NateDogg247/EEE3094S---Lab-2-PTRJUN003-/data/reference_images/README.md

# Original pre-lab reference

The supplied handwritten model/force-diagram photograph is preserved unchanged as original source material. The report uses typeset equations and clean vector diagrams; this photograph is not a report figure.
