NateDogg247/EEE3094S---Lab-2-PTRJUN003-/data/rubric/README.md

# Supplied marking rubric

Original rubric images supplied for this report revision. These are marking instructions, not experimental measurements. Identification/check and step-circuit evidence are in `../session1/evidence`; the original model, scope and controller test are in `../session2`.
