NateDogg247/EEE3094S---Lab-2-PTRJUN003-/report/sections/appendices.tex

\section{Parameter Check and Final Board}\label{app:evidence}\label{app:photos}
\Fref{fig:paramcheck} records the submitted parameters and the laboratory check results. The displayed scores support the identification values used in \Sref{sec:id}; they are not uncertainty intervals.
\begin{figure}[H]\raggedright
\begin{minipage}[t]{.39\linewidth}\vspace{0pt}
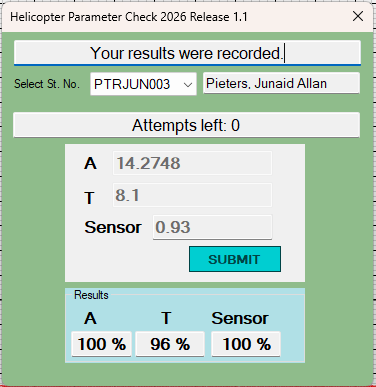
[picture p1: data/session1/evidence/parameter_check.png]
\href{\RepoRoot/tree/\RepoBranch/data/session1/evidence}{}
\end{minipage}\hfill
\begin{minipage}[t]{.57\linewidth}\vspace{0pt}
\small
\begin{tabular}{lll}\toprule\thead
Parameter & Submitted & Score\\\midrule
$A$ & 14.2748 & 100\%\\
$\tau$ & 8.1 s & 96\%\\
$k_s$ & 0.93 V/m & 100\%\\\bottomrule
\end{tabular}
\par\vspace{8pt}The check reports ``Your results were recorded'' for PTRJUN003. The numerical values agree with the model in the original Simulink diagram. The source image and identification circuit reference are retained in the \RepoLink{data/session1/evidence}{evidence folder}.
\end{minipage}
\caption{Original Helicopter Parameter Check result for the adopted model.}\label{fig:paramcheck}
\end{figure}
\Fref{fig:board} documents the final Veroboard controller described in \Sref{sec:hardware}. The three op-amp packages and adjustable bias trimmer are visible. The schematic records the intended connections; a top-side photograph alone does not establish underside continuity.
\repfig{hardware}{../../hardware/veroboard.jpeg}{.70}{Final physical controller on Veroboard. The enlarged circuit is \Fref{fig:circuit}; the editable design is in the \RepoLink{hardware/kicad}{KiCad folder}.}{fig:board}
\page

\section{Demo Record and Original Simulink Scope}\label{app:demo}\label{app:simulink}
The controller demonstration received full marks (20/20). \Fref{fig:demo} retains the required screenshot of tracking the setpoint. At 86.10 s it displays reference 5.033 m, height 4.897 m, command 2.498 V and sensor 4.553 V. The displayed error is 0.137 m; subtraction of rounded heights gives 0.136 m.
\repfig{data/session2}{../../data/session2/hardware_step_test.jpeg}{.80}{Original controller tracking screenshot required by the lab brief. The numerical response is replotted in \Fref{fig:hardware}.}{fig:demo}
\Fref{fig:originalscope} is the original supplied Simulink plot, preserved for comparison with the original model in \Fref{fig:originalmodel}. 
\repfig{data/session2}{../../data/session2/simulink_scope.png}{.80}{Original Simulink scope: reference (yellow), command (blue) and altitude (orange). The matched-reference comparison is \Fref{fig:simcomparison}.}{fig:originalscope}
Digitised values are approximate: Simulink altitude resolution is 0.0124 m/pixel, while the demo plot resolution is 0.0417 m/pixel. Source images, processed CSVs and \RepoLink{matlab/simulink}{Simulink reproduction scripts} remain accessible through the linked repository folders.
\page

\section{Supporting Calculations}\label{app:calculations}
\label{app:circuit}\label{app:loading}\label{app:adjustment}
The following enlarged KiCad view shows the bias source feeding U3. $R_{11}$ connects to ground; $R_{13}$ connects to $-15$ V. The pot wiper is loaded through $R_9$, so its unloaded voltage alone does not determine hover output.
\begin{figure}[H]\raggedright
\begin{minipage}[t]{.32\linewidth}\vspace{0pt}
\href{\RepoRoot/tree/\RepoBranch/hardware/kicad}{}
\end{minipage}\hfill
\begin{minipage}[t]{.64\linewidth}\vspace{0pt}\small
\textbf{DAQ connections:} DAC-1 reference, DAC-0 sensor, ADC-1 controller output, ADC-2 sensor monitor. All grounds are common. Op-amp pin 7 is $+15$ V and pin 4 is $-15$ V.
\par\vspace{6pt}U1: $a_f=R_4/R_3$, $a_r=(1+a_f)R_2/(R_1+R_2)$; nominally both are 0.01. U2: $g_2=1+R_5/R_6=1.47$. U3: $g_3=(1+R_{10}/(R_9+R_{\mathrm{th}}))R_8/(R_7+R_8)$.
\end{minipage}
\caption{Bias network and DAQ mapping supporting the enlarged signal stages in \Fref{fig:circuit}.}\label{fig:biasnetwork}
\end{figure}
For the unloaded network, $R_P=10\parallel1.2=1.071429$ k$\Omega$ and $I=-15/(3.9+R_P+22)=-0.556143$ mA. Thus $V_A=-2.168962$ V, $V_B=-2.764831$ V and $V_{\rm th}=V_A+W(V_B-V_A)$. Solving the loaded hover condition gives $W=0.783081$, $R_{\rm th}=5.423001$ k$\Omega$ and $V_{\rm th}=-2.635575$ V:
\begin{align}
u_0&=-\frac{100}{100+5.423001}(-2.635575)=2.500000\unit{V},\\
g_3&=\frac{1+100/(100+5.423001)}2=0.974280,\\
K_p&=0.01(1.47)(0.974280)=0.014321913.
\end{align}
The reported 2.565 V potentiometer adjustment is an observation at an unlogged node/time. A permanent zero-error bias of 2.565 V instead of 2.5 V would predict $\delta y=0.065/(0.01432\times0.93)=4.88076$ m, so it is not silently substituted for theoretical hover. The isolated 5 m step initially commands 2.566588 V; the matched Simulink sequence reaches 2.564405 V.

Independent resistor errors change $K_f=a_fg_2g_3$ and $y_\infty/x_\infty=a_r/a_f$. The 2,048 resistor/drag corners give 48.79\% maximum error and 38.95\% overshoot. For example, $a_f=0.9/110$ and $a_r=(1+a_f)1.1/(90+1.1)$ give $a_r/a_f=1.487864$. Matched ratios and two 680 $\Omega$ U1 resistors give $K_p=0.00973890$ and 23.44\% worst scalar overshoot; physical retesting is required.
At the selected root $s_d=-0.0617284+j0.1402123$, pole angles are $113.7615^\circ$ and $66.2385^\circ$ (sum $180^\circ$). The magnitude condition gives
\begin{equation}
K_p=\frac{|s_d||s_d+0.1234568|}{1.6389585}=\frac{(0.1531988)^2}{1.6389585}=0.01432.
\end{equation}
\RepoLink{calculations}{Extended calculations}, \RepoLink{analysis/modules}{Python code}, \RepoLink{matlab/design}{MATLAB root locus}, \RepoLink{matlab/simulink}{Simulink tests} and \RepoFile{CODE_GUIDE.md}{reproduction instructions} are supplied outside the report.
