NateDogg247/EEE3094S---Lab-2-PTRJUN003-/calculations/PTRJUN003_Lab2_Calculations.pdf

# Worked Calculations

### EEE3094S Lab 2 – PTRJUN003

Junaid Allan Pieters

## 1 Model, Inputs and Definitions

The original CSV and screenshot are retained in the data folder. (https://github.com/NateDogg247/EEE3094S---Lab-2-PTRJUN003-/tree/main/data) The Python modules (https://github.com/NateDogg247/EEE3094S---Lab-2-PTRJUN003-/tree/main/analysis/modules) calculate the values below; MATLAB design code (https://github.com/NateDogg247/EEE3094S---Lab-2-PTRJUN003-/tree/main/matlab/design) provides the root-locus method. This supplement contains worked substitutions rather than additional experiments.

∆u = 5.0 − 2.5 = 2.5 V, | uh = 2.5 V, | (1.1)
Gy(s) = | 14.2748
s(8.1s + 1), | ks = 0.93 V/m, | (1.2)

b =

1
8.1

= 0.123456790 s⁻¹
, | kT =
| 14.2748
| 8.1
| = 1.762320988, | (1.3)
L(s) = KpksGy(s), | Kp = 0.01432. | (1.4)

The closed-loop reference is a position step from 0 to 5 m; the identification input is a voltage step from 2.5 to 5.0 V. They are different signals.

ks =

P
i
P
| yiyv,i

i

y

2
i
| . | (1.5)

Mp = 100e

−πζ/√
1−ζ

2
. | (1.6)

y(t) = 5
1 − e

−σt
cos ωdt +

σ
ωd

sin ωdt

. | (1.7)

δy =

δub
Kpks
| . | (1.8)

The circuit coefficients used for tolerance calculations are

af = R4/R3, | ar = (1 + af )R2/(R1 + R2), | (1.9)
g2 = 1 + R5/R6, | g3 = (1 + R10/(R9 + Rth))R8/(R7 + R8). | (1.10)

2 Detailed Calculations

## 2 Detailed Calculations

### 2.1 Model Derivation and Signal Definitions

Table 2.1: Model notation and units.

Symbol | Description | Unit
x, y, v = ˙y | Reference altitude, altitude, vertical velocity | m, m, m/s
ft
, g, da | Mass-normalised thrust, gravity, disturbance | m/s²
b, kT | Drag coefficient; local voltage-to-thrust slope | s⁻¹ ; m/(s² V)
u, uh, δu | Command, hover command, u − uh | V
A, τ | Velocity gain; velocity time constant | m/(s V); s
ks | Position-to-voltage coefficient | V/m
rv, yv, ev | Reference, sensor, error voltage | V
Kp | Proportional voltage-error gain | V/V

Start from y¨ = ft−by˙ −g+da, with ft = g+kT (u−uh). For da = 0, zero initial conditions and v = ˙y,

v˙ + bv = kT δu, | (2.1)
(s + b)V (s) = kT ∆U(s), | (2.2)
Gv(s) = kT
s + b

=

kT /b
s/b + 1

=

A
τs + 1
| , | (2.3)

Gy(s) = Gv(s)
| s = A
| s(τs + 1). | (2.4)

The identified parameters give b = 1/8.1 = 0.123456790 s⁻¹ and kT = 14.2748/8.1 = 1.762320988 m/(s² V). The hover voltage does not imply kT = g/uh.

For negative feedback, Ey = X − Y and L = KpksGy:

Ey(s)
X(s)

=

1
1 + L(s)
| = τs² + s
| τs² + s + AKpks
| . | (2.5)

For a step X = x0/s, the final-value theorem gives e∞ = lims→0 sEy(s) = 0. For a ramp X = ar/s²
,
e∞ =

ar
AKpks
, | Kv = AKpks = 0.190106076. | (2.6)

A parabolic reference has unbounded steady error. A constant acceleration disturbance d0 instead gives y∞−x∞ = d0/(kT Kpks). For an input bias, d0 = kT δub, so δy = δub/(Kpks).

### 2.2 Identification and Timing

Table 2.2 gives selected original samples and derived velocities. The finite manual step is evident in the input column. Endpoint times are listed for consistency with the CSV; each derivative physically belongs to its interval midpoint.

Table 2.2: Selected identification samples and backward-difference results.

t [s] | u [V] | yv [V] | y [m] | vi [m/s]
15.7 | 2.495 | 0.000 | 0.000 | 0.00
15.8 | 2.908 | 0.000 | 0.000 | 0.00
15.9 | 4.607 | 0.000 | 0.000 | 0.00
16.0 | 5.000 | 0.034 | 0.037 | 0.37
16.9 | 5.000 | 2.098 | 2.256 | 4.08
17.0 | 5.000 | 2.513 | 2.703 | 4.47
23.9 | 5.000 | 10.000 | 104.823 | 22.36
24.0 | 5.000 | 10.000 | 107.076 | 22.53
24.1 | 5.000 | 10.000 | 109.345 | 22.69
v(24.0) = (107.076 − 104.823)/0.1 = 22.53 m/s, | (2.7)
v(24.1) = (109.345 − 107.076)/0.1 = 22.69 m/s, | (2.8)

v¯∞ =

1
404

X

ti≥120

yi − yi−1
0.1
= 35.68747525 m/s, | (2.9)
A = (35.68747525 − 0)/2.5 = 14.27499010 m/(s V), | (2.10)
v63 = 0.632(35.68747525) = 22.55448436 m/s, | (2.11)

t63 = 24.0 + 0.1

22.55448436 − 22.53
22.69 − 22.53
= 24.01530272 s, | (2.12)
τ63 = 24.01530272 − 15.9 = 8.11530272 s. | (2.13)

The exponential fit minimises P
17≤ti≤60[vi − V∞(1 − e

−(ti−t0)/τ )]²
. Its outputs are V∞ =
35.68747059 m/s, τ = 8.10393362 s and t0 = 15.91583783 s. These two methods corrobo-rate rounding to τ = 8.1 s. They do not create two experimental trials.

The sensor least-squares fit in Equation (1.5) excludes zero and clipped pairs. The check ks(2.703) = 0.93(2.703) = 2.51379 V agrees with the recorded 2.513 V within rounding.

### 2.3 Root-Locus Geometry and Gain Bound

Step 1 – Form the loop without the variable gain. Include the sensor coefficient explicitly:
G0(s) = ksGy(s) = 14.2748(0.93) s(8.1s + 1) =

1.638958519
s(s + 0.123456790). | (2.14)
Step 2 – Locate poles and asymptotes. The two poles are p1 = 0 and p2 = −0.123456790; there are no finite zeros. The real-axis locus is between the poles. With n − m = 2,

σa =

p1 + p2
2

= −0.061728395, θℓ =

(2ℓ + 1)180◦
2

= 90◦

, 270◦
. (2.15)
Step 3 – Calculate breakaway. From 1 + KpG0(s) = 0,

Kp(s) = −

s(8.1s + 1)
14.2748(0.93), | (2.16)

dKp
ds = −

16.2s + 1
13.275564
= 0 | ⇒ | sb = −

1
16.2
= −0.061728395, | (2.17)

Kp,b =

1
4(8.1)(14.2748)(0.93) = 0.002324888. | (2.18)
Step 4 – Apply the overshoot bound. Solving 0.30 = e

−πζ/√
1−ζ

2
gives

ζmin =

− ln 0.30
p
π

2 + (ln 0.30)²

= 0.357857131. | (2.19)

The characteristic polynomial is s

2 + s/8.1 + (14.2748)(0.93)Kp/8.1. Matching coefficients gives ω

2
n = AKpks/τ and 2ζωn = 1/τ , hence

Kp <

1
4τAksζ

2
min

=

1
4(8.1)(14.2748)(0.93)(0.357857131)²

= 0.018154432. (2.20)

The adopted Kp = 0.01432 lies between breakaway and the nominal overshoot limit. The complex branches have fixed decay rate σ = 1/(2τ ) = 0.061728395 s⁻¹
; they cannot reach
σ = 4/30 = 0.133333 s⁻¹ by changing Kp alone.

### 2.4 Selected Gain and Pole Calculations

Step 5 – Check the adopted gain. This value is retained from the supplied controller design; the calculations test its performance. Substitution gives
q = AKpks = (14.2748)(0.01432)(0.93) = 0.190106076, | (2.21)
Gcl(s) = | 0.190106076
8.1s

2 + s + 0.190106076

, | (2.22)

ωn =

p
q/τ =

p
0.190106076/8.1 = 0.153198845 rad/s, | (2.23)

ζ =

1
2

√τ q

=

1
2

p
8.1(0.190106076)
= 0.402929900, | (2.24)

ωd =

p
ω²
n − σ
2 = 0.140212308 rad/s, | (2.25)

s1,2 =

−1 ±

p
1 − 4(8.1)(0.190106076)
2(8.1) | = −0.061728395 ± j0.140212308. | (2.26)
The damping predicts Mp = 100e | −π(0.402929900)/

√
1−0.402929900² = 25.080375%. The next angle and magnitude checks verify that these poles lie on the proportional root locus.

### 2.5 Root-Locus Angle and Magnitude Checks

Step 6 – Verify the pole position. The locus for variable Kp uses G0(s) = ksGy(s) = (Aks/τ )/[s(s + 1/τ )], where Aks/τ = 1.638959 s⁻²
. At the selected upper pole sd = −0.0617284 + j0.1402123,

∠sd = 113.76147◦

, | ∠(sd + 1/τ ) = 66.23853◦
| , | (2.27)
∠G0(sd) = −113.76147◦ − 66.23853◦ = −180◦
| , | (2.28)

Kp =

1
|G0(sd)|

=

|sd| |sd + 1/τ |
Aks/τ | =
| (0.153198845)²
| 1.63895852
| = 0.01432. | (2.29)

Both the negative-feedback angle criterion and magnitude criterion are satisfied. The quadratic roots independently give the same pole pair.

### 2.6 Nominal Step and Settling Calculation

Step 7 – Evaluate the time response. Substituting into Equation (1.7),

y(t) = 5 -1 − e

−0.061728395t
(cos(0.140212308t) + 0.44025 sin(0.140212308t)) . (2.30)

The first peak occurs at tp = π/ωd = 22.405969 s. Since cos π = −1 and sin π = 0,

y(tp) = 5[1 + e

−0.061728395(22.405969)] = 6.254019 m, | (2.31)

so Mp = (6.254019 − 5)/5 × 100 = 25.080375%.

Step 8 – Calculate settling. The error envelope satisfies |y − 5|/5 ≤ e

−σt/

p
| 1 − ζ
| 2 .
Solving this bound for 2% gives

Tenv = −

ln(0.02√
1 − 0.4029299²
)
0.061728395
= 64.80975 s. | (2.32)

Actual settling is found by evaluating the full response, locating the last sample for which |y − 5| > 0.1 m, and taking the next sample. A 0.005 s grid gives 54.89 s. This definition agrees with reference-based settling calculations [1].

Step 9 – Check command headroom. Command headroom follows from u = 2.5 + Kpks(5 − y): the highest command is 2.566588 V at the step, and the lowest is 2.5 − 0.01432(0.93)(1.254019) = 2.483299 V at the altitude peak. Neither reaches the 0 or 5 V limit.

### 2.7 Aerodynamic and Component Uncertainty

With fixed kT , the uncertain characteristic polynomial is s

2 + b

′
s + kT Kpks. The worst
scalar case has b

′ = 0.9b0 and K′
p = 1.1Kp,0. Applying the required damping ratio gives

Kp,0 <

(0.9b0)

2
4kT ksζ

2

min(1.1) =

0.81
1.1
(0.01815443) = 0.01336826. | (2.33)

At the supplied gain the worst-case damping is (0.9/

√
1.1)(0.4029299) = 0.34575, and Equation (1.6) gives 31.42% overshoot. This explains why passing drag-only uncertainty is insufficient for the joint case.

For independent loop-resistor tolerances, use the U1 coefficients and U2/U3 gains defined in Section 3. Assign each of R1–R10 either 0.9 or 1.1 times its nominal value, then use both drag extremes. There are 2¹⁰ × 2 = 2048 cases. The bias network is held at its nominal Thevenin resistance and zero-error output is recalibrated in each case. Table 2.3 reports this optimistic subset.

Table 2.3: Independent loop-resistor corner predictions.

Quantity | Range / worst value
Feedback gain Kf | 0.009072–0.022784
Reference/feedback ratio ar/af | 0.672104–1.487864
Absolute DC tracking error | 48.7864%
Overshoot about each case’s own final altitude | 38.9461%

For example, R1 = 0.9(100 kΩ), R2 = 1.1(1 kΩ), R3 = 1.1(100 kΩ) and R4 = 0.9(1 kΩ) give

af = 0.9/110 = 0.00818182,

ar
af

=

(1 + 0.00818182)(1.1)/(90 + 1.1) 0.00818182

= 1.487864.

(2.34)
Thus a 5 m reference tends to 7.43932 m even after hover recalibration. The type number cannot remove unequal reference and feedback scaling.

### 2.8 Practical Gain and Ratio Correction

The corner distributions in Figure 2.1 separate dynamic overshoot from DC ratio error.

20 | 30 | 40

### Overshoot (%)

0

50

100

150

### Corner count

0 | 20 | 40

### Tracking error after bias trim (%)

0

200

400

600

800

Corner count (https://github.com/NateDogg247/EEE3094S---Lab-2-PTRJUN003-/tree/main/analysis/modules)

Figure 2.1: Loop-resistor corners. Dashed limits are 30% overshoot and 8% tracking error. The histograms show corner counts, not probabilities. Code: Python; (https://github.com/NateDogg247/EEE3094S---Lab-2-PTRJUN003-/tree/main/analysis/modules) MATLAB. (https://github.com/NateDogg247/EEE3094S---Lab-2-PTRJUN003-/tree/main/matlab/plots) Data: results. (https://github.com/NateDogg247/EEE3094S---Lab-2-PTRJUN003-/tree/main/results)

Failure in this subset rejects a guarantee for all components. Bias-network and op-amp variations can add error. After matching the U1 ratios, a practical gain correction is to replace both 1 kΩ resistors with matched 680 Ω values:

Kp,new =

680
100000
(1.47)(0.97427980) = 0.009738901, | (2.35)

ζworst =

0.9b0
2

p
kT (1.1Kp,new)ks
≈ 0.4193, | (2.36)
Mp,worst ≈ 23.44%, | (2.37)
|δub|max = 0.08(5)(0.009738901)(0.93) = 3.623 mV. | (2.38)

This scalar check assumes matched reference and feedback ratios; it is not a guarantee for independent resistor corners. Lower gain increases damping but tightens the hover-bias allowance. The board must be recalibrated and retested after any change.

### 2.9 Reported Potentiometer Adjustment and Command Calculations

The complete physical three-op-amp controller was connected during the controller test. The student reported adjusting the physical potentiometer until the input was approximately 2.565 V, with the aim of tracking the setpoint with minimal overshoot. No time series or exact measurement instant accompanies that recollection. The retained terminal display independently records a 2.498 V command at 86.10 s.

For the isolated 0-to-5 m reference test, starting at zero altitude,

rv(0⁺) = ksx = 0.93(5) = 4.650 V, | | (2.39)
ev(0⁺) = rv − yv = 4.650 − 0 = 4.650 V, | (2.40)
δu(0⁺) = Kpev = 0.01432(4.650) = 0.066588 V, | (2.41)
u(0⁺) = uh + δu = 2.500000 + 0.066588 = 2.566588 V, | (2.42)
ureported − u(0⁺) = 2.565 − 2.566588 = −0.001588 V. | (2.43)

The difference in voltage magnitude is approximately 1.59 mV. This comparison does not establish that the reported observation was measured at the same instant or node as the model command.

For the supplied Simulink startup sequence, define the unit closed-loop response

h(t) = 1 − e

−σt
cos ωdt +

σ
ωd

sin ωdt

, | h(t) = 0 for t < 0. | (2.44)

Superposition gives y(t) = 2.5h(t) + 2.5h(t − 2.5) for a reference of 2.5 m initially and 5 m after 2.5 s. Consequently,

u(2.5

+) = 2.5 + 0.01432(0.93){5 − 2.5h(2.5)} = 2.564405 V. | (2.45)

This maximum differs from the reported 2.565 V by approximately 0.595 mV. The original scope’s voltage resolution is approximately 0.0124 V/pixel, so it cannot verify either millivolt difference.

The command during a reference error must be distinguished from the zero-error hover bias. If 2.565 V were instead held as a constant zero-error command, its 65 mV excess would predict

δy =

2.565 − 2.500
Kpks

=

0.065
0.01432(0.93) = 4.88076 m. | (2.46)

That is not a negligible hover-bias change. Therefore the reported adjustment is docu-mented as a practical test observation, rather than silently replacing the nominal 2.500 V hover term or the calculated controller gain. Changing the bias alone does not change the damping ratio or remove the proportional controller’s settling limitation.

### 2.10 Experimental Metrics and Uncertainty

The digitised plot uses pixel bounds x = 602 . . . 1414 for 0–120 s and py = 60 . . . 540 for 20–0 m. Therefore

t =

x − 602
1414 − 602
| (120), | h =

540 − py
540 − 60
(20), | (2.47)
∆t = 0.147783 s/pixel, | ∆h = 0.041667 m/pixel. | (2.48)

The extracted peak is 6.229167 m at 22.019704 s. With the displayed reference, terminal height and zero starting altitude,

ef = 5.033 − 4.897 = 0.136 m, | (2.49)
ηtrack = 100(1 − 0.136/5.033) = 97.297834%, | (2.50)
Mp,ref = 100(6.229167 − 5.033)/5.033 = 23.766475%, | (2.51)
δMp,ref ≈ 100(0.041667)/5.033 = 0.82787 percentage points. | (2.52)

This practical overshoot metric uses the commanded reference. If the terminal display is used as a proxy for the actual settled output, the conventional final-output-normalised overshoot is (6.229167 − 4.897)/4.897 × 100 ≈ 27.20%. Both estimates are below 30%, but the screenshot alone does not establish an exact asymptotic output. Table 2.4 compares the analytical, simulated and experimental metrics.

Table 2.4: Comparison of calculation, simulation and retained experiment.

Metric | Analytical | Simulation | Experiment
Reference | 5.000 m | 5.000 m | 5.033 m
Peak | 6.25402 m | 6.25402 m | ≈ 6.229 m
Peak time | 22.40597 s | 22.405 s | ≈ 22.020 s
Reference overshoot | 25.0804% | 25.0804% | ≈ 23.7665%
Tracking accuracy | 100% ideal | → 100% | 97.2978% displayed
2% reference settling | 64.81 s envelope | 54.89 s | Not established

For the 5.033 m reference the 8% band is 5.033(1 ± 0.08) = 4.63036–5.43564 m. The 2% band is 4.93234–5.13366 m. The terminal height lies inside the first but outside the second. The discrepancy cannot be removed by redefining the settling band around the biased terminal value while claiming reference tracking.

The command-bias calculation uses Equation (1.8): δy = 0.002/(0.01432 × 0.93) = 0.150177 m. The illustrative test in Figure 4.1 injects a positive 2 mV bias at 70 s; it is a model prediction rather than a recorded disturbance experiment.

3 Circuit Gain and Bias Loading

## 3 Circuit Gain and Bias Loading

With the wiper unloaded, RP = P1 ∥ R12 = 10 ∥ 1.2 = 1.0714286 kΩ. The end-to-end current and pot-end voltages are

I =

−15
3.9 + 1.0714286 + 22
= −0.556143 mA, | (3.1)
VA = I(3.9) = −2.168962 V, | VB = I(3.9 + 1.0714286) = −2.764831 V, | (3.2)
Vth = VA + W(VB − VA). | (3.3)

Set the supply sources to zero and inject a 1 A test current at the wiper. The node-conductance equations for A, B and the wiper are
G11 + G12 + Gt | −G12 | −Gt
−G12 | G13 + G12 + Gb | −Gb
−Gt | −Gb | Gt + Gb

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
- , | (3.4)

where Gi = 1/Ri

, Gt = 1/(W P1) and Gb = 1/[(1 − W)P1]. The test voltage V

′
w gives
Rth. Solving the hover equation

−

R10
R9 + Rth(W)
Vth(W) = 2.5 | (3.5)

gives W = 0.783080594, Rth = 5423.0014 Ω and Vth = −2.6355750 V. The loaded zero-error wiper is −2.500 V.

For U3, define r = R10/(R9 + Rth) = 0.94855960. Since the non-inverting divider gives V+ = V2/2, virtual short and KCL give

u = (1 + r)V+ − rVth =

1 + r
2
V2 − rVth, | (3.6)

g3 =

1 + 0.94855960
2
= 0.97427980, | (3.7)

Kp =

1

100 1 +
4.7

10
(0.97427980) = 0.014321913. | (3.8)

The ideal buffered result 0.0147 differs by 2.57%, while the selected model value 0.01432 differs from the loaded calculation by only 0.0134%. These are circuit-model calculations; a measured input/output slope of the final board was not supplied.

References

## 4 Defined Disturbance Prediction

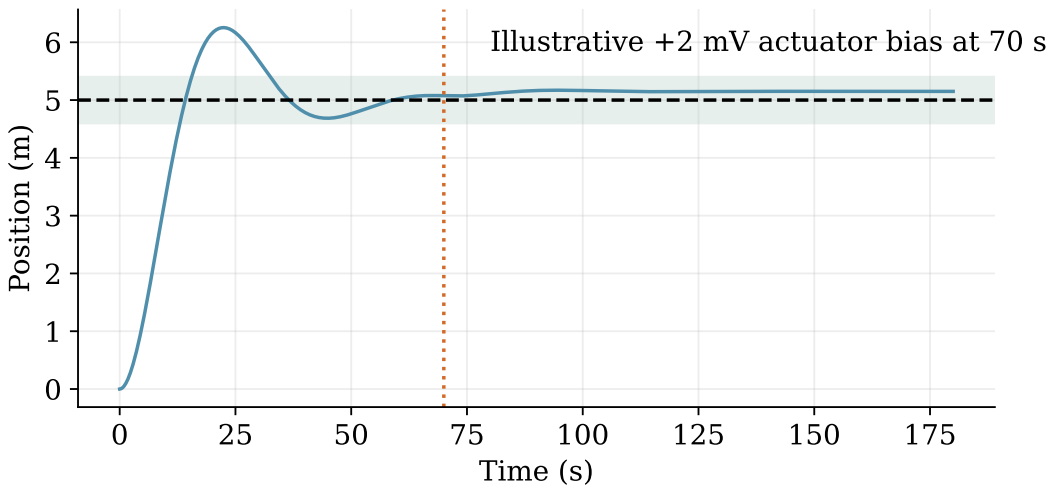
[picture p15: figure]
Time (s); Position (m)

Illustrative +2 mV actuator bias at 70 s (https://github.com/NateDogg247/EEE3094S---Lab-2-PTRJUN003-/tree/main/analysis/modules)

Figure 4.1: Prediction for a +2 mV command bias introduced at 70 s; the shaded band is the 8% reference band. Code: Python; (https://github.com/NateDogg247/EEE3094S---Lab-2-PTRJUN003-/tree/main/analysis/modules) MATLAB. (https://github.com/NateDogg247/EEE3094S---Lab-2-PTRJUN003-/tree/main/matlab/plots) Data: results. (https://github.com/NateDogg247/EEE3094S---Lab-2-PTRJUN003-/tree/main/results)

The nominal shift is 0.002/(0.01432 × 0.93) = 0.150177 m. This simulation is a prediction for a specified disturbance, not an experimentally measured rejection test.

## References

[1] MathWorks, stepinfo: official documentation. (https://www.mathworks.com/help/control/ref/dynamicsystem.stepinfo.html)
