NateDogg247/EEE3094S---Lab-2-PTRJUN003-/report/main.tex

\documentclass[12pt,a4paper,fleqn]{article}
\usepackage[utf8]{inputenc}
\usepackage[english]{babel}
\usepackage[top=1in,bottom=1in,left=1in,right=1in,headheight=15pt]{geometry}
\usepackage{microtype,amsmath,amssymb,graphicx,booktabs,array,tabularx,float}
\usepackage[table]{xcolor}
\usepackage{tikz,circuitikz,fancyhdr,enumitem,listings,caption,titlesec}
\usepackage{ragged2e}
\setlength{\mathindent}{0pt}
\usetikzlibrary{arrows.meta,positioning,calc}
\definecolor{AngelBlue}{HTML}{8FC9E6}
\definecolor{LinkBlue}{HTML}{397B9C}
\colorlet{navy}{LinkBlue}
\usepackage[unicode,colorlinks=true,linkcolor=LinkBlue,urlcolor=LinkBlue,citecolor=LinkBlue,bookmarksnumbered=true]{hyperref}
\hypersetup{pdftitle={EEE3094S Lab 2: Proportional Control},pdfauthor={Junaid Allan Pieters},pdfsubject={Kitticopter modelling, identification and proportional control}}
\providecommand{\ReportRoot}{}
\providecommand{\ProjectRoot}{../}
\graphicspath{{\ReportRoot figures/}}
% Computer Modern, margins and leading follow the supplied LaTeX template.
\linespread{1.03}
\setlength{\parskip}{5pt plus1pt minus1pt}
\setlength{\parindent}{0pt}
\setlength{\intextsep}{7pt}
\setlength{\textfloatsep}{8pt}
\setlength{\emergencystretch}{2em}
\widowpenalty=10000\clubpenalty=10000
\setlist{nosep,leftmargin=*}
\renewcommand{\arraystretch}{1.14}
\renewcommand{\tabularxcolumn}[1]{>{\RaggedRight\arraybackslash}p{#1}}
\newcolumntype{P}[1]{>{\RaggedRight\arraybackslash}p{#1}}
\captionsetup{font=small,labelfont=bf,skip=4pt,justification=raggedright,singlelinecheck=false}
\pagestyle{fancy}\fancyhf{}
\fancyhead[L]{\small\nouppercase{\leftmark}}\fancyfoot[L]{\thepage}
\renewcommand{\headrulewidth}{0pt}
% Chapter-style headings follow the supplied previous-year report.
\titleformat{\section}[hang]{\normalfont\Large\bfseries}
  {\thesection}{0.6em}{}
\titlespacing*{\section}{0pt}{0pt}{10pt}
\titlespacing*{\subsection}{0pt}{8pt}{5pt}
\numberwithin{equation}{section}
\makeatletter
\renewcommand{\@pnumwidth}{2.2em}
\renewcommand{\@tocrmarg}{3.2em}
\makeatother
\counterwithin{figure}{section}\counterwithin{table}{section}
\newcommand{\HRule}{\textcolor{AngelBlue}{\rule{\linewidth}{0.5mm}}}
\newcommand{\fig}[4]{\begin{figure}[H]\raggedright\href{\RepoRoot/tree/\RepoBranch/report/figures}{}\caption{#3}\label{#4}\end{figure}}
\newcommand{\plot}[4]{\begin{figure}[H]\raggedright\href{\RepoRoot/tree/\RepoBranch/analysis/modules}{}\caption{#3 \RepoLink{analysis/modules}{Python}, \RepoLink{matlab/plots}{MATLAB}, \RepoLink{results}{data}.}\label{#4}\end{figure}}
\newcommand{\repfig}[5]{\begin{figure}[H]\raggedright\href{\RepoRoot/tree/\RepoBranch/#1}{}\caption{#4}\label{#5}\end{figure}}
\newcommand{\page}{\clearpage}
\newcommand{\unit}[1]{\,\mathrm{#1}}
\newcommand{\Fref}[1]{\hyperref[#1]{Figure~\ref*{#1}}}
\newcommand{\Tref}[1]{\hyperref[#1]{Table~\ref*{#1}}}
\newcommand{\Aref}[1]{\hyperref[#1]{Appendix~\ref*{#1}}}
\newcommand{\Sref}[1]{\hyperref[#1]{Section~\ref*{#1}}}
\newcommand{\Eref}[1]{\hyperref[#1]{Equation~(\ref*{#1})}}
\newcommand{\thead}{\rowcolor{AngelBlue!28}}
\input{\ReportRoot repository.tex}
\begin{document}
\RaggedRight
\setlength{\abovedisplayskip}{5pt}
\setlength{\belowdisplayskip}{5pt}
\setlength{\abovedisplayshortskip}{4pt}
\setlength{\belowdisplayshortskip}{4pt}
\fancypagestyle{plain}{\fancyhf{}\fancyfoot[L]{\thepage}\renewcommand{\headrulewidth}{0pt}}
\hypersetup{pageanchor=false}
\begin{titlepage}\thispagestyle{empty}\begin{flushleft}
{\LARGE Lab 2 Report}\\[0.3cm]
{\large Proportional Control}\\[0.6cm]
\textcolor{AngelBlue}{\rule{0.60\linewidth}{0.5pt}}\\[1.0cm]
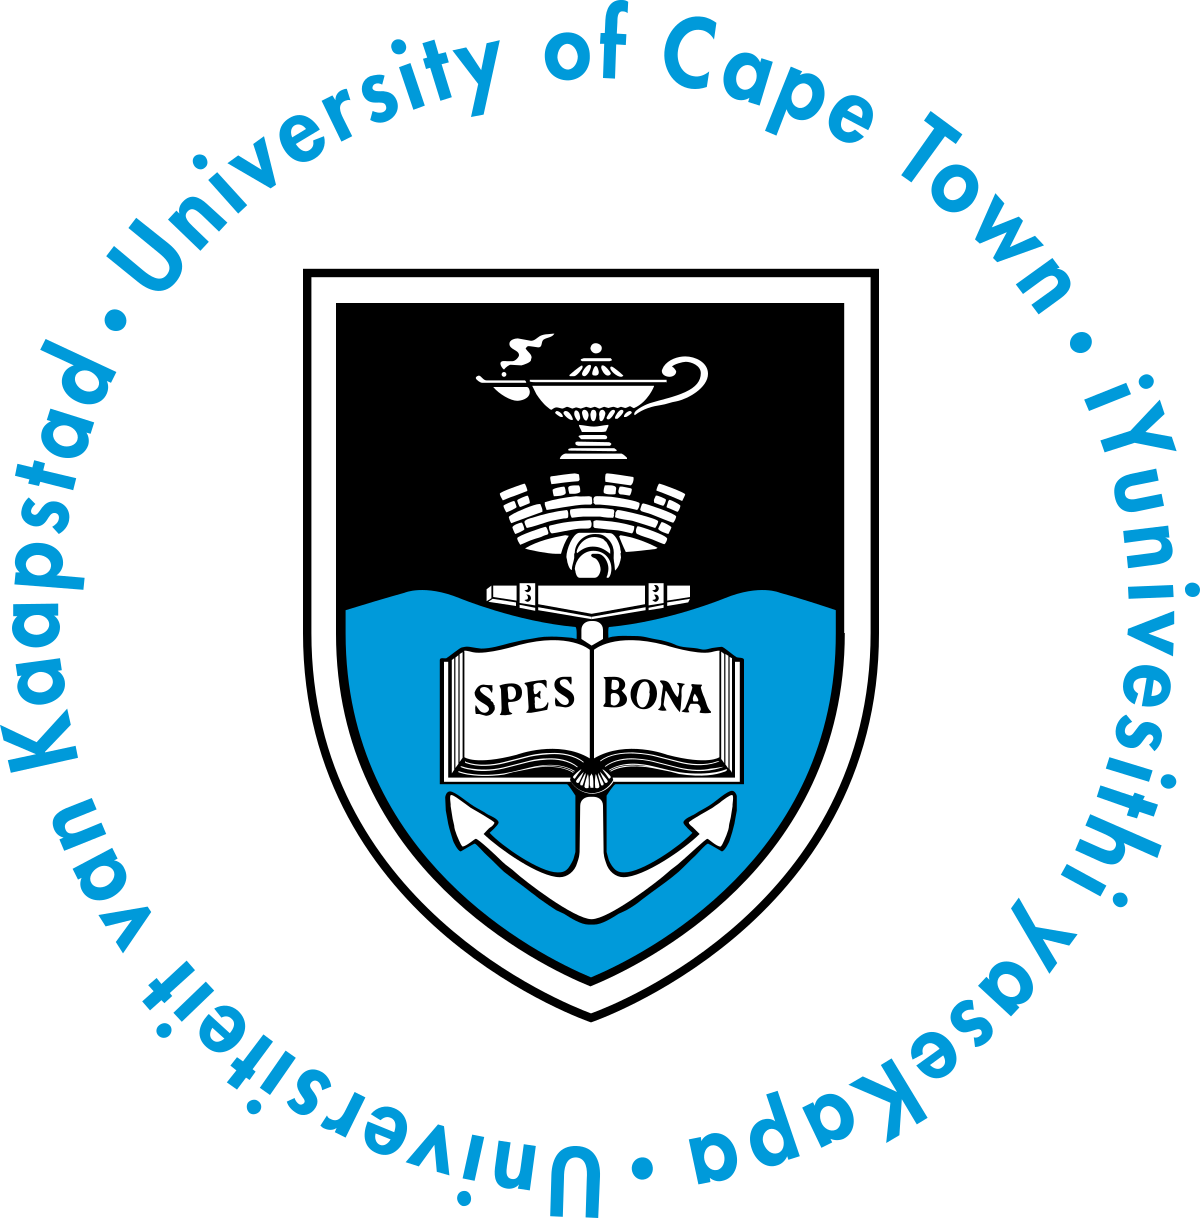
[picture p16: report/figures/UCTLOGO.png]
\\[1.2cm]
{\large\textbf{Prepared by:}}\\[0.15cm]
Junaid Allan Pieters\\PTRJUN003\\[0.9cm]
{\large\textbf{Prepared for:}}\\[0.15cm]
EEE3094S Control Systems Engineering\\
Department of Electrical Engineering\\
University of Cape Town
\vfill
11 October 2026
\end{flushleft}\end{titlepage}
\hypersetup{pageanchor=true}
\pagenumbering{roman}
\begingroup\small\setlength{\parskip}{0pt}\tableofcontents\endgroup\clearpage
\pagenumbering{arabic}
\input{\ReportRoot sections/body.tex}
\label{main:last}
\clearpage
\renewcommand{\thepage}{R\arabic{page}}\setcounter{page}{1}
\input{\ReportRoot sections/references.tex}
\clearpage\appendix
\titleformat{\section}[hang]{\normalfont\Large\bfseries}
  {Appendix \thesection:}{0.5em}{}[\thispagestyle{plain}]
\titlespacing*{\section}{0pt}{0pt}{15pt}
\renewcommand{\thepage}{A\arabic{page}}\setcounter{page}{1}
\input{\ReportRoot sections/appendices.tex}
\end{document}
