NateDogg247/EEE3094S---Lab-2-PTRJUN003-/report/figures/free_body_diagram.pdf

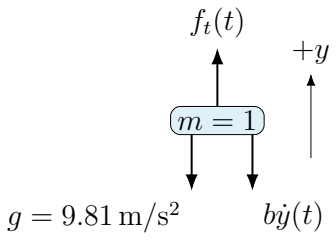
[picture p18: figure]
