NateDogg247/EEE3094S---Lab-2-PTRJUN003-/report/figures/nominal_response.pdf

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

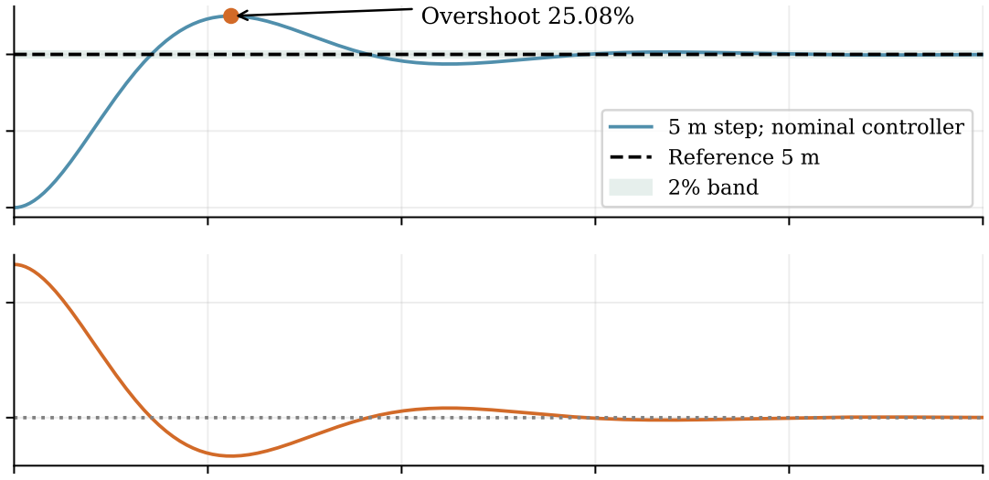
[picture p20: figure]
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
