NateDogg247/EEE3094S---Lab-2-PTRJUN003-/data/reference_images/original_pre_lab_notes.jpeg

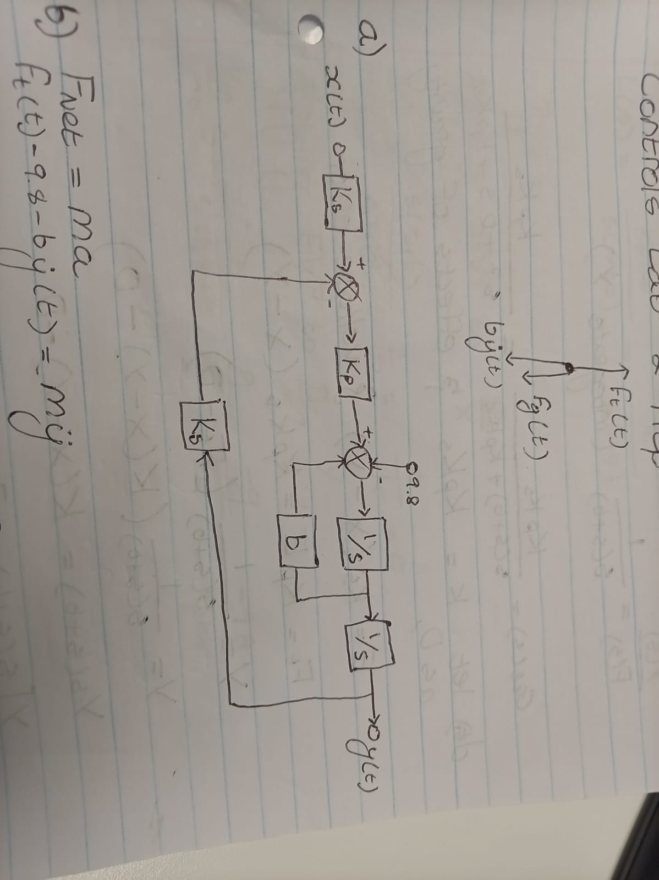
data/reference_images/original_pre_lab_notes.jpeg
