NateDogg247/EEE3094S---Lab-2-PTRJUN003-/data/rubric/controller_design.png

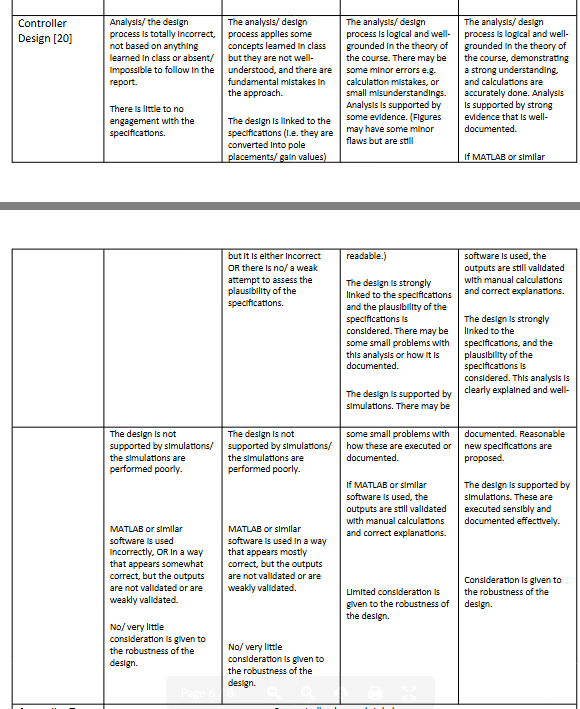
data/rubric/controller_design.png
