NateDogg247/EEE3094S---Lab-2-PTRJUN003-/data/rubric/identification_and_design.png

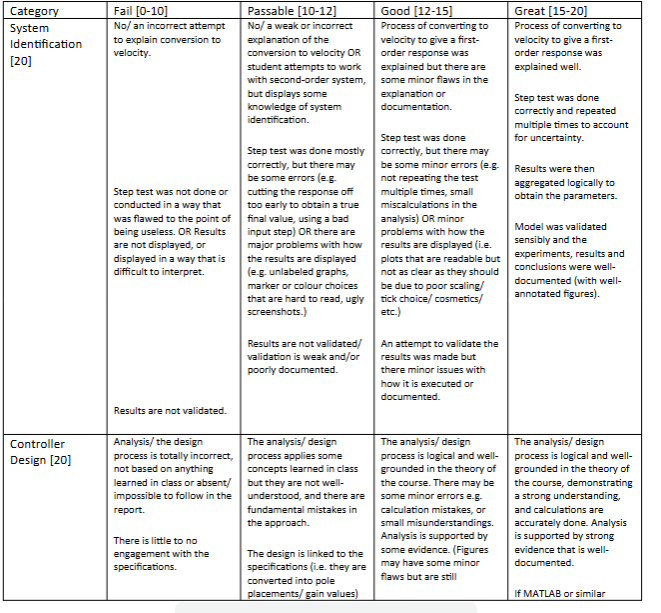
data/rubric/identification_and_design.png
