NateDogg247/EEE3094S---Lab-2-PTRJUN003-/hardware/kicad/Kitticopter_3OpAmp_preview.png

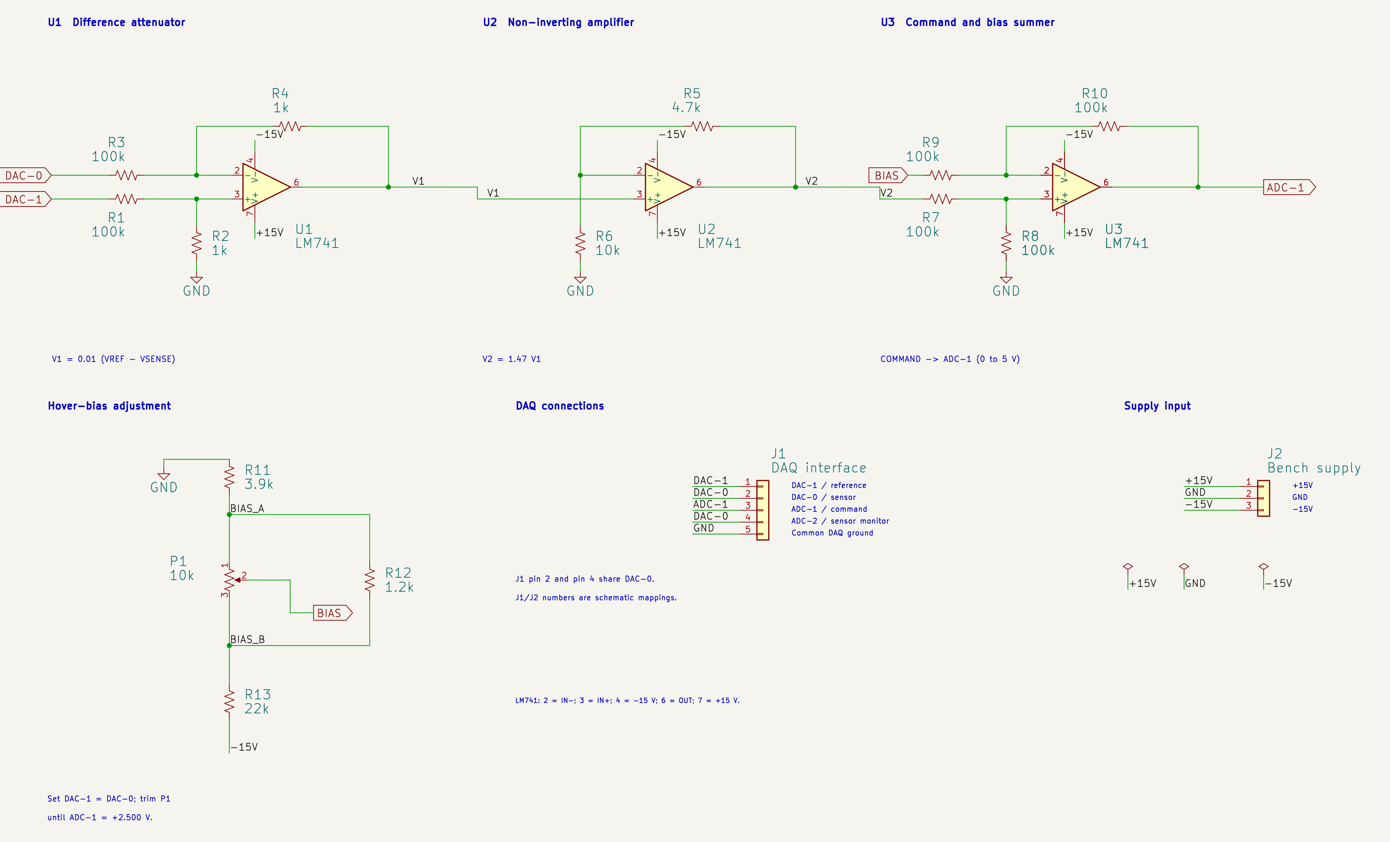
hardware/kicad/Kitticopter_3OpAmp_preview.png
