NateDogg247/EEE3094S---Lab-2-PTRJUN003-/hardware/kicad/style_reference.png

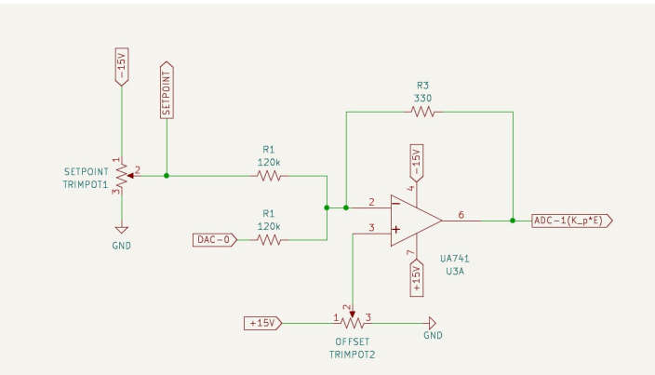
hardware/kicad/style_reference.png
