NateDogg247/EEE3094S---Lab-2-PTRJUN003-/hardware/supplied_circuit_reference.jpeg

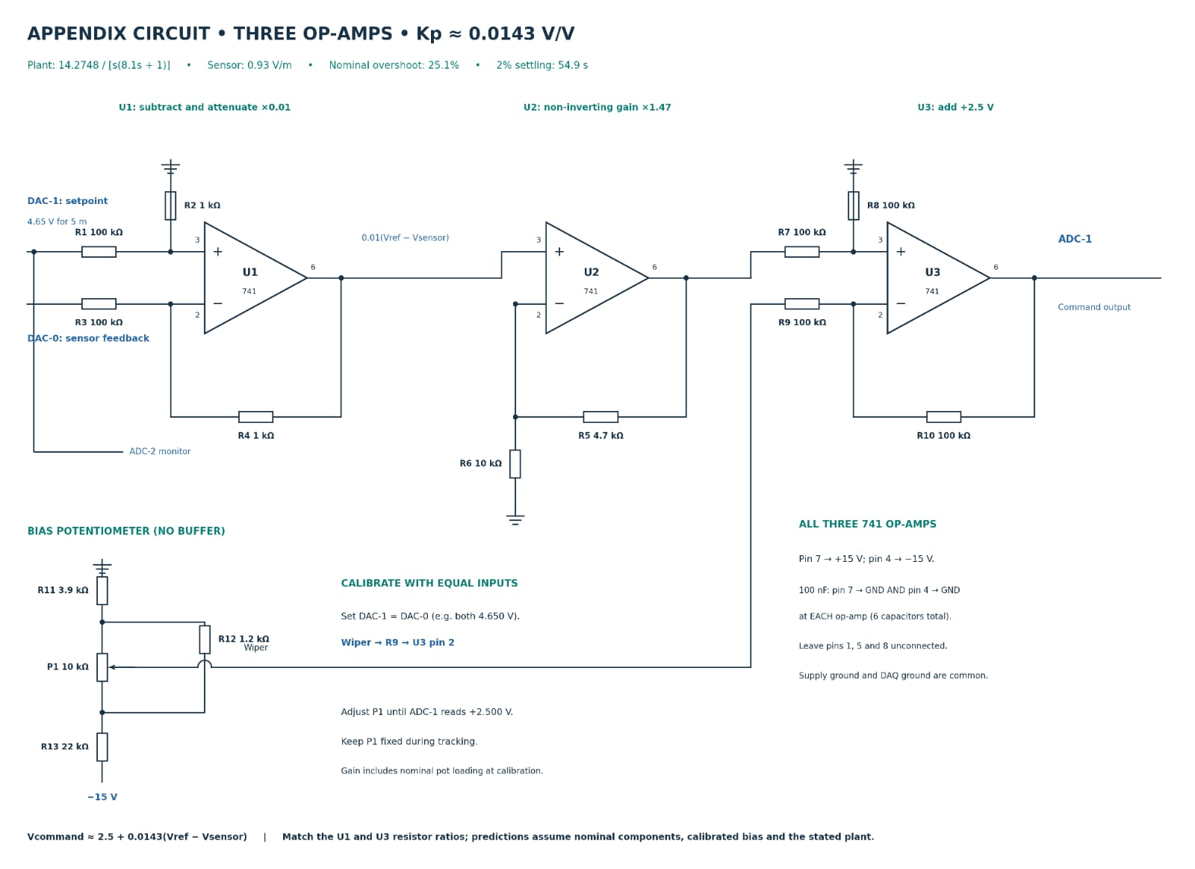
hardware/supplied_circuit_reference.jpeg
