NateDogg247/EEE3094S---Lab-2-PTRJUN003-/report/figures/disturbance_prediction.png

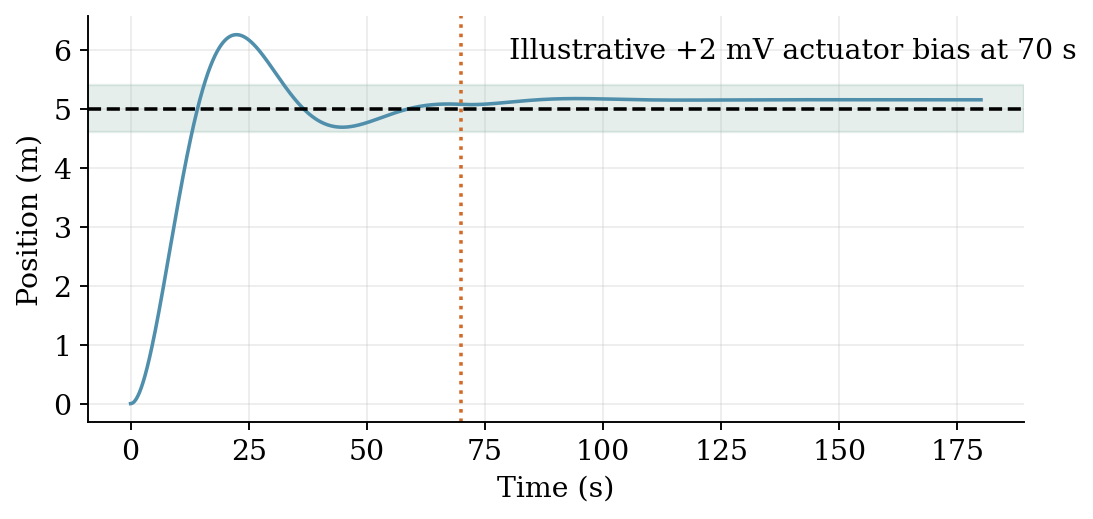
report/figures/disturbance_prediction.png
