NateDogg247/EEE3094S---Lab-2-PTRJUN003-/report/figures/hardware_comparison.png

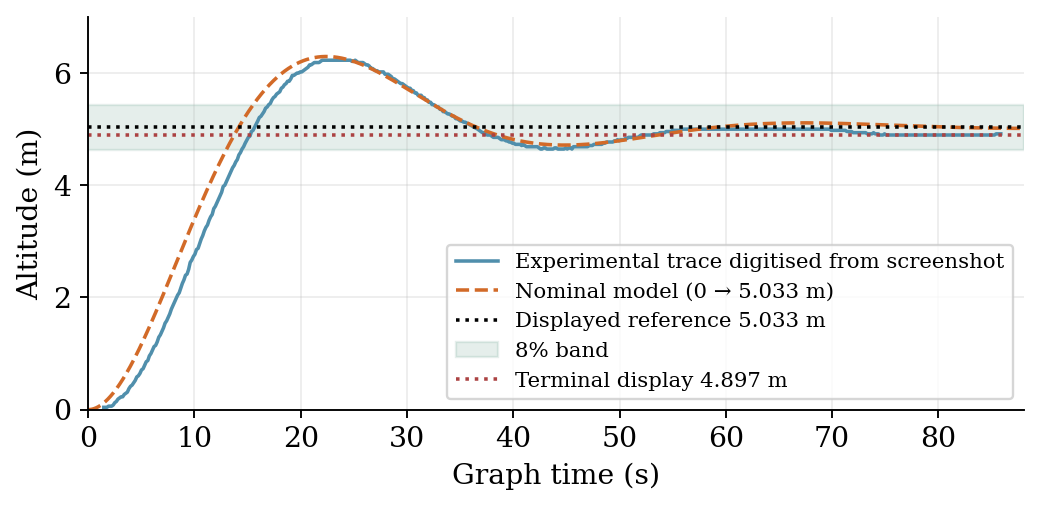
report/figures/hardware_comparison.png
