NateDogg247/EEE3094S---Lab-2-PTRJUN003-/report/figures/nominal_response.png

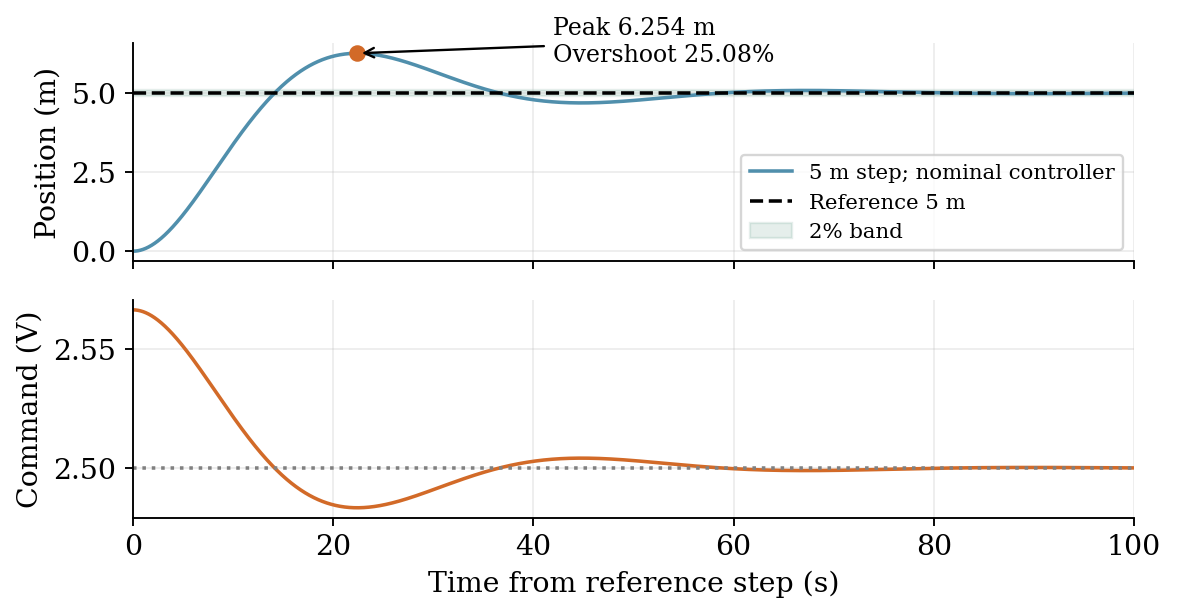
report/figures/nominal_response.png
