NateDogg247/EEE3094S---Lab-2-PTRJUN003-/report/figures/root_locus.png

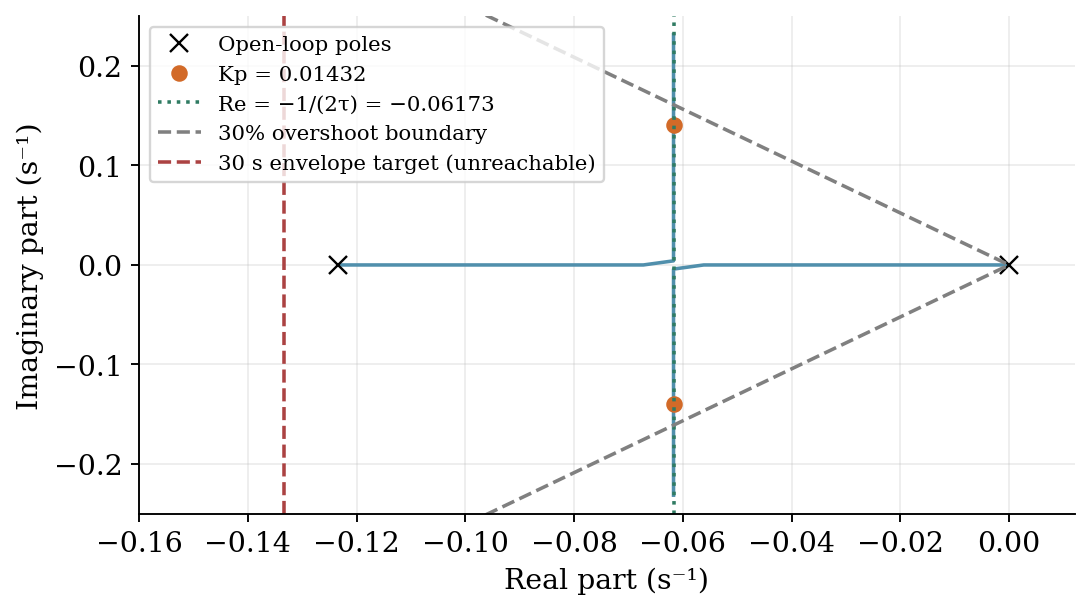
report/figures/root_locus.png
