NateDogg247/EEE3094S---Lab-2-PTRJUN003-/report/figures/simulink_comparison.png

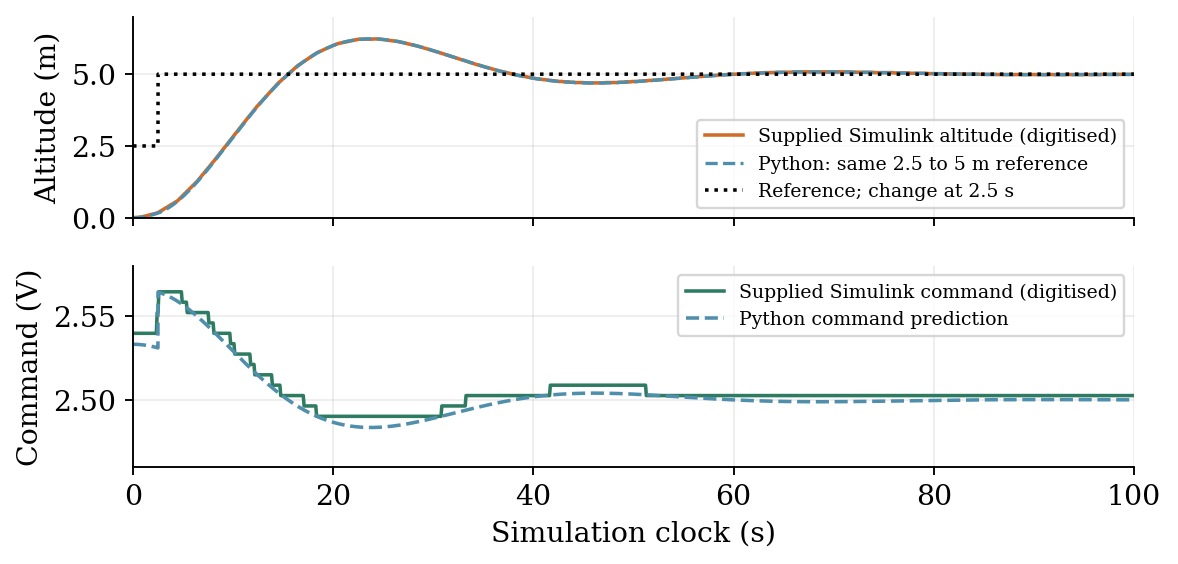
report/figures/simulink_comparison.png
