NateDogg247/EEE3094S---Lab-2-PTRJUN003-/hardware/kicad/BOM.csv

Reference | Value | Symbol | Footprint
U1 | LM741 | LM741 | Package_DIP:DIP-8_W7.62mm
U2 | LM741 | LM741 | Package_DIP:DIP-8_W7.62mm
U3 | LM741 | LM741 | Package_DIP:DIP-8_W7.62mm
R3 | 100k | R_US
R1 | 100k | R_US
R4 | 1k | R_US
R2 | 1k | R_US
R5 | 4.7k | R_US
R6 | 10k | R_US
R9 | 100k | R_US
R7 | 100k | R_US
R10 | 100k | R_US
R8 | 100k | R_US
R11 | 3.9k | R_US
P1 | 10k | R_Potentiometer_US
R13 | 22k | R_US
R12 | 1.2k | R_US
J1 | DAQ interface | Conn_01x05
J2 | Bench supply | Conn_01x03
