NateDogg247/EEE3094S---Lab-2-PTRJUN003-/report/figures/component_robustness.png

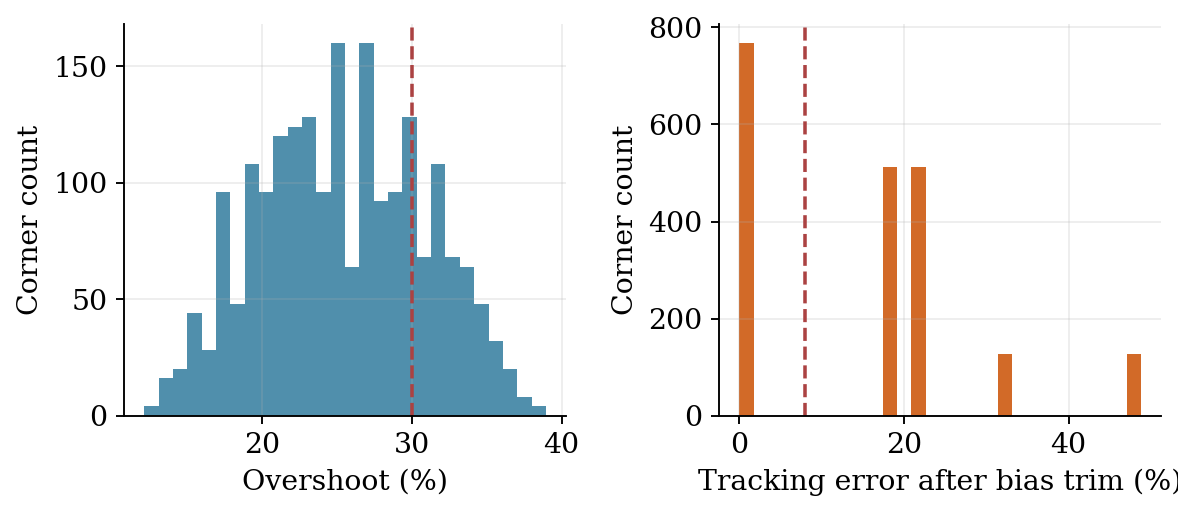
report/figures/component_robustness.png
