NateDogg247/EEE3094S---Lab-2-PTRJUN003-/data/session1/evidence/step_test_circuit_original.png

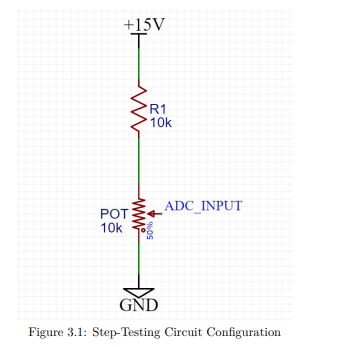
data/session1/evidence/step_test_circuit_original.png
