NateDogg247/EEE3094S---Lab-2-PTRJUN003-/report/figures/identification_step_circuit.png

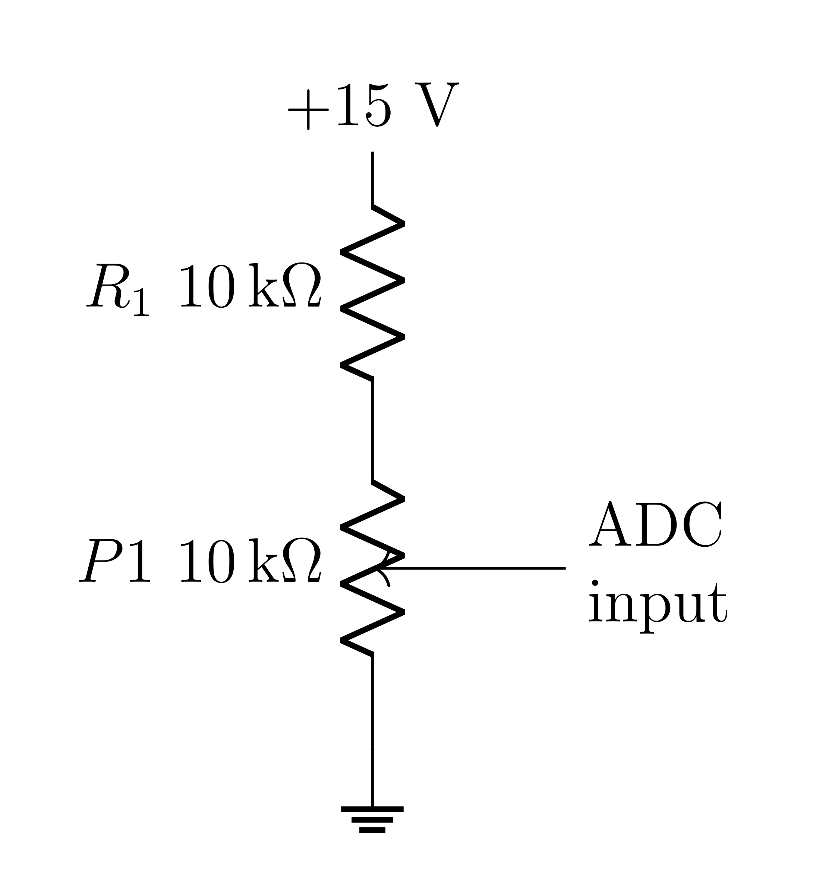
report/figures/identification_step_circuit.png
