NateDogg247/EEE3094S---Lab-2-PTRJUN003-/report/figures/position_validation.pdf

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

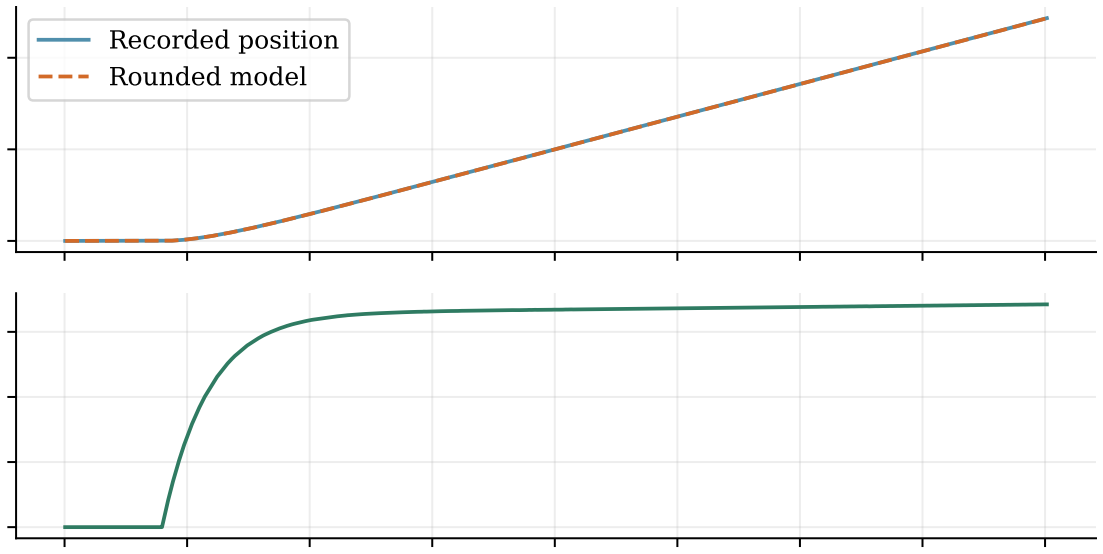
[picture p38: figure]
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
