NateDogg247/EEE3094S---Lab-2-PTRJUN003-/results/independent_resistor_corners.csv

b_factor | feedback_kp | reference_feedback_ratio | tracking_error_percent | overshoot_percent
0.9 | 0.014282290851916984 | 1.0 | 0.0 | 29.395519786972518
1.1 | 0.014282290851916984 | 1.0 | 0.0 | 21.100260084938842
0.9 | 0.01582279993012076 | 1.0 | 0.0 | 31.515338395556334
1.1 | 0.01582279993012076 | 1.0 | 0.0 | 23.20354169943078
0.9 | 0.013081093384349164 | 1.0 | 0.0 | 27.57330690217762
1.1 | 0.013081093384349164 | 1.0 | 0.0 | 19.313308022125373
0.9 | 0.01435466969198231 | 1.0 | 0.0 | 29.500291913856785
1.1 | 0.01435466969198231 | 1.0 | 0.0 | 21.203613895915673
0.9 | 0.015710519937108685 | 1.0 | 0.0 | 31.368233158121733
1.1 | 0.015710519937108685 | 1.0 | 0.0 | 23.056779152086484
0.9 | 0.017405079923132838 | 1.0 | 0.0 | 33.47871469403494
1.1 | 0.017405079923132838 | 1.0 | 0.0 | 25.173239033394033
0.9 | 0.014389202722784081 | 1.0 | 0.0 | 29.55008985049723
1.1 | 0.014389202722784081 | 1.0 | 0.0 | 21.252760240607245
0.9 | 0.015790136661180544 | 1.0 | 0.0 | 31.47265711524757
1.1 | 0.015790136661180544 | 1.0 | 0.0 | 23.160947829403508
0.9 | 0.012854061766725287 | 1.0 | 0.0 | 27.210043982744974
1.1 | 0.012854061766725287 | 1.0 | 0.0 | 18.95955758085817
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
