NateDogg247/EEE3094S---Lab-2-PTRJUN003-/results/nominal_simulation.csv

time_s | reference_m | nominal_position_m | command_v
0.0 | 5 | 0.0 | 2.566588
0.005 | 5 | 1.4665660242750871e-06 | 2.5665879804688605
0.01 | 5 | 5.865056497027391e-06 | 2.5665879218915237
0.015 | 5 | 1.3193659566819762e-05 | 2.566587824292119
0.02 | 5 | 2.3450562781592132e-05 | 2.5665876876947853
0.025 | 5 | 3.663395309009527e-05 | 2.5665875121236663
0.03 | 5 | 5.274201684332402e-05 | 2.5665872976029167
0.035 | 5 | 7.177293979594998e-05 | 2.566587044156697
0.04 | 5 | 9.372490710775374e-05 | 2.566586751809177
0.045 | 5 | 0.00011859610334505636 | 2.566586420584534
0.05 | 5 | 0.00014638471248215062 | 2.566586050506953
0.055 | 5 | 0.0001770889179027314 | 2.5665856416006267
0.06 | 5 | 0.000210706902401326 | 2.5665851938897566
0.065 | 5 | 0.00024723684818472326 | 2.5665847073985506
0.07 | 5 | 0.00028667693687340273 | 2.5665841821512254
0.075 | 5 | 0.00032902534950296296 | 2.5665836181720056
0.08 | 5 | 0.0003742802665255495 | 2.5665830154851226
0.085 | 5 | 0.0004224398678112823 | 2.5665823741148164
0.09 | 5 | 0.0004735023326496819 | 2.5665816940853348
0.095 | 5 | 0.0005274658397510966 | 2.5665809754209326
0.1 | 5 | 0.0005843285672481277 | 2.566580218145873
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
