NateDogg247/EEE3094S---Lab-2-PTRJUN003-/results/session1_measured_input_validation.csv

time_s | velocity_from_measured_input_mps
15.7 | 0.0
15.8 | 0.03536685397202636
15.9 | 0.25548855381421065
16.0 | 0.6558795181661126
16.1 | 1.0857038495804443
16.2 | 1.5102542713136837
16.3 | 1.9295955511751905
16.4 | 2.3437916042093
16.5 | 2.7529055612366315
16.6 | 3.1569997784762442
16.7 | 3.5561358470498723
16.8 | 3.9503746023695476
16.9 | 4.339776133409894
17.0 | 4.724399791866868
17.1 | 5.104304201203907
17.2 | 5.479547265587227
17.3 | 5.850186178711492
17.4 | 6.216277432517039
17.5 | 6.577876825800372
17.6 | 6.935039472718784
17.7 | 7.287819811190777
17.8 | 7.636271611193403
17.9 | 7.980447982957673
18.0 | 8.320401385063594
18.1 | 8.65618363243571
18.2 | 8.987845904240633
18.3 | 9.315438751687717
18.4 | 9.639012105733853
18.5 | 9.958615284693936
18.6 | 10.274297001757768
18.7 | 10.586105372414844
18.8 | 10.894087921788044
18.9 | 11.198291591877217
19.0 | 11.498762748714073
19.1 | 11.795547189429104
19.2 | 12.088690149231919
19.3 | 12.378236308305906
19.4 | 12.664229798618237
19.5 | 12.946714210646425
19.6 | 13.225732600022214
19.7 | 13.501327494094065
19.8 | 13.773540898409093
19.9 | 14.042414303115399
20.0 | 14.307988689285972
20.1 | 14.570304535164873
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
