NateDogg247/EEE3094S---Lab-2-PTRJUN003-/results/session1_processed.csv

Time(s) | Input(v) | Output(v) | Output(m) | Velocity(m/s) | Velocity_time_midpoint(s) | Model_velocity(m/s) | Model_position(m)
0.1 | 2.456 | 0.0 | 0.0 |  |  | 0.0 | 0.0
0.2 | 2.456 | 0.0 | 0.0 | 0.0 | 0.15000000000000002 | 0.0 | 0.0
0.3 | 2.456 | 0.0 | 0.0 | 0.0 | 0.25 | 0.0 | 0.0
0.4 | 2.456 | 0.0 | 0.0 | 0.0 | 0.35 | 0.0 | 0.0
0.5 | 2.456 | 0.0 | 0.0 | 0.0 | 0.45 | 0.0 | 0.0
0.6 | 2.456 | 0.0 | 0.0 | 0.0 | 0.55 | 0.0 | 0.0
0.7 | 2.456 | 0.0 | 0.0 | 0.0 | 0.6499999999999999 | 0.0 | 0.0
0.8 | 2.456 | 0.0 | 0.0 | 0.0 | 0.75 | 0.0 | 0.0
0.9 | 2.456 | 0.0 | 0.0 | 0.0 | 0.8500000000000001 | 0.0 | 0.0
1.0 | 2.456 | 0.0 | 0.0 | 0.0 | 0.95 | 0.0 | 0.0
1.1 | 2.456 | 0.0 | 0.0 | 0.0 | 1.05 | 0.0 | 0.0
1.2 | 2.456 | 0.0 | 0.0 | 0.0 | 1.15 | 0.0 | 0.0
1.3 | 2.456 | 0.0 | 0.0 | 0.0 | 1.25 | 0.0 | 0.0
1.4 | 2.456 | 0.0 | 0.0 | 0.0 | 1.35 | 0.0 | 0.0
1.5 | 2.456 | 0.0 | 0.0 | 0.0 | 1.45 | 0.0 | 0.0
1.6 | 2.456 | 0.0 | 0.0 | 0.0 | 1.55 | 0.0 | 0.0
1.7 | 2.456 | 0.0 | 0.0 | 0.0 | 1.65 | 0.0 | 0.0
1.8 | 2.456 | 0.0 | 0.0 | 0.0 | 1.75 | 0.0 | 0.0
1.9 | 2.456 | 0.0 | 0.0 | 0.0 | 1.85 | 0.0 | 0.0
2.0 | 2.456 | 0.0 | 0.0 | 0.0 | 1.95 | 0.0 | 0.0
2.1 | 2.456 | 0.0 | 0.0 | 0.0 | 2.05 | 0.0 | 0.0
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
