NateDogg247/EEE3094S---Lab-2-PTRJUN003-/results/simulink_scope_digitised.csv

time_s_digitised | altitude_m_digitised | command_V_digitised
0.0 | 0.0 | 2.5398230088495577
0.08340283569641367 | 0.0 | 2.5398230088495577
0.16680567139282734 | 0.0 | 2.5398230088495577
0.25020850708924103 | 0.012389380530973451 | 2.5398230088495577
0.3336113427856547 | 0.012389380530973451 | 2.5398230088495577
0.4170141784820684 | 0.012389380530973451 | 2.5398230088495577
0.5004170141784821 | 0.012389380530973451 | 2.5398230088495577
0.5838198498748958 | 0.012389380530973451 | 2.5398230088495577
0.6672226855713094 | 0.024778761061946902 | 2.5398230088495577
0.7506255212677231 | 0.024778761061946902 | 2.5398230088495577
0.8340283569641368 | 0.024778761061946902 | 2.5398230088495577
0.9174311926605505 | 0.030973451327433628 | 2.5398230088495577
1.0008340283569641 | 0.03716814159292035 | 2.5398230088495577
1.0842368640533777 | 0.049557522123893805 | 2.5398230088495577
1.1676396997497915 | 0.049557522123893805 | 2.5398230088495577
1.2510425354462051 | 0.061946902654867256 | 2.5398230088495577
1.3344453711426187 | 0.06814159292035399 | 2.5398230088495577
1.4178482068390326 | 0.0743362831858407 | 2.5398230088495577
1.5012510425354462 | 0.08672566371681416 | 2.5398230088495577
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
