NateDogg247/EEE3094S---Lab-2-PTRJUN003-/data/rubric/demo_evaluation_and_report.png

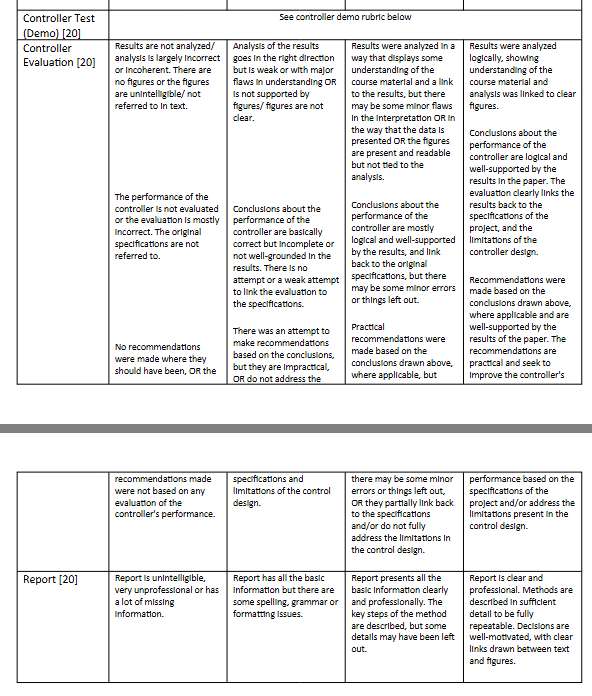
data/rubric/demo_evaluation_and_report.png
