NateDogg247/EEE3094S---Lab-2-PTRJUN003-/report/figures/position_validation.png

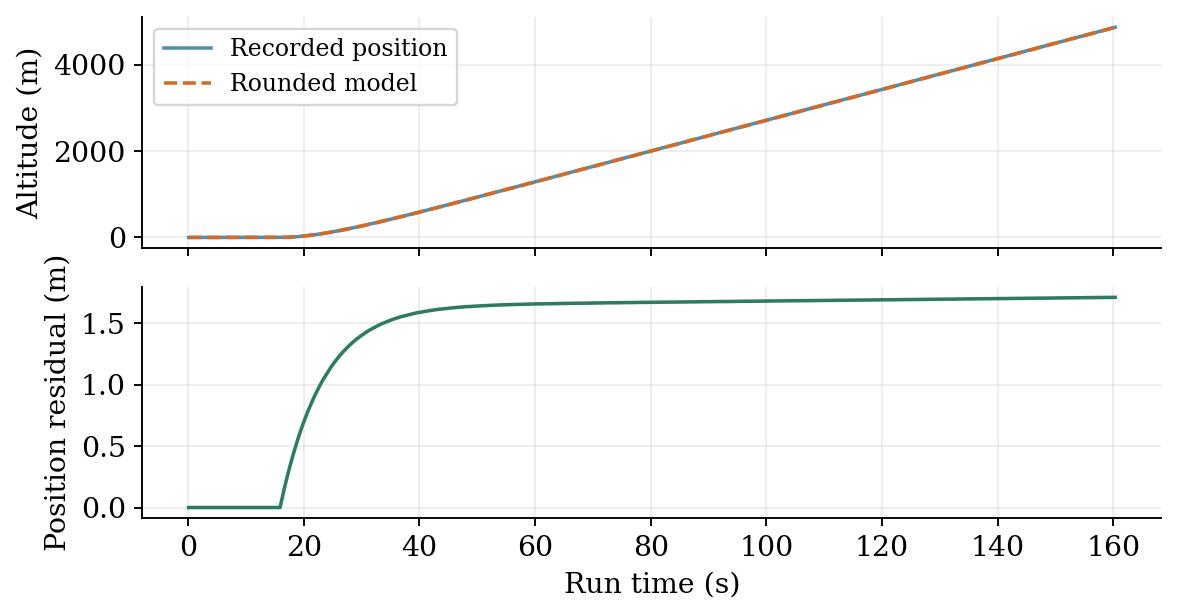
report/figures/position_validation.png
