NateDogg247/EEE3094S---Lab-2-PTRJUN003-/report/figures/validation_sensor.png

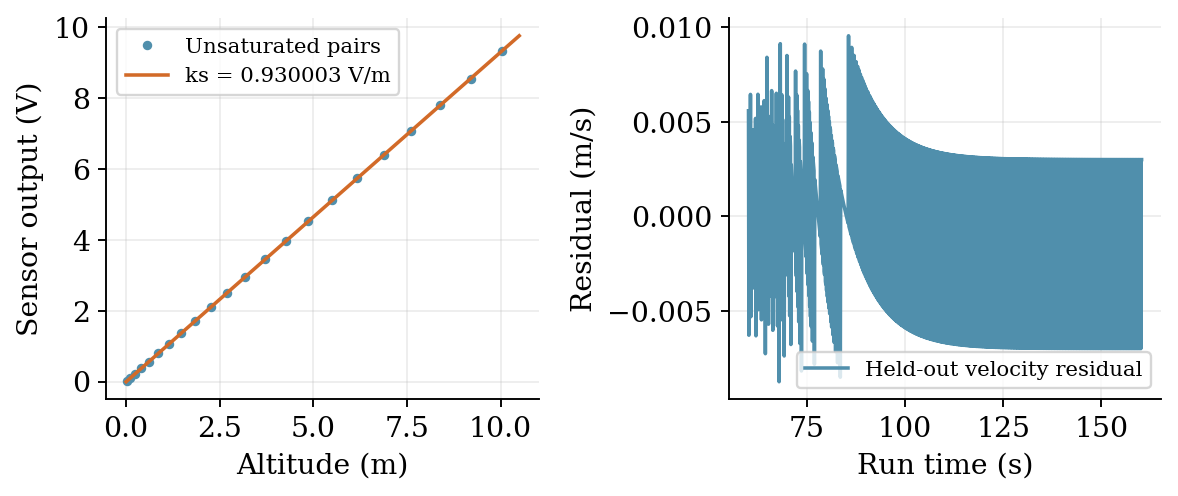
report/figures/validation_sensor.png
