NateDogg247/EEE3094S---Lab-2-PTRJUN003-/report/figures/aerodynamic_robustness.pdf

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

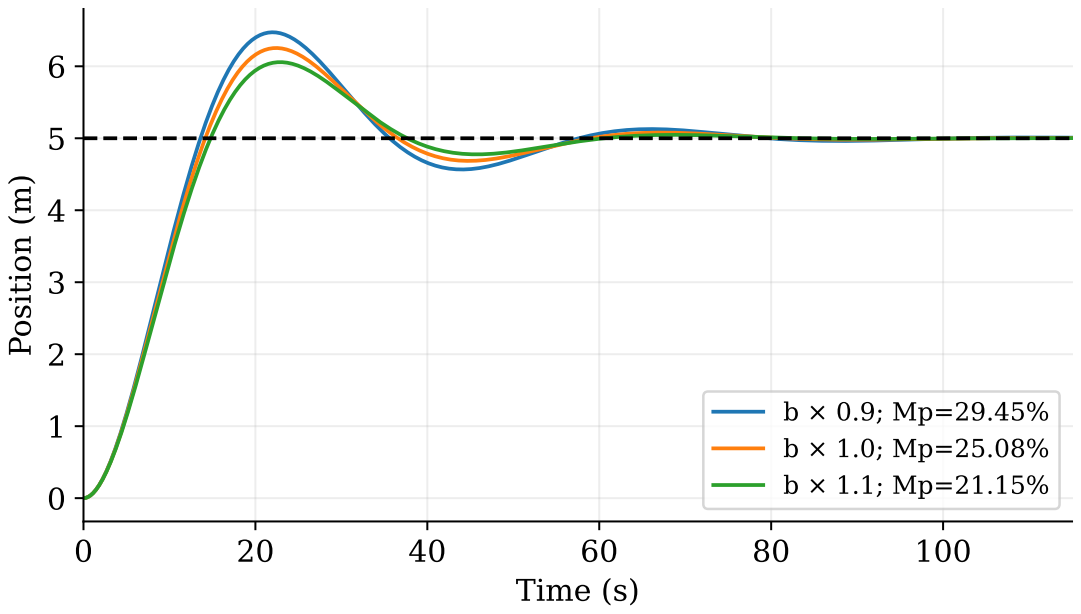
[picture p42: page 1]
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
