NateDogg247/EEE3094S---Lab-2-PTRJUN003-/report/figures/kicad_bias.pdf

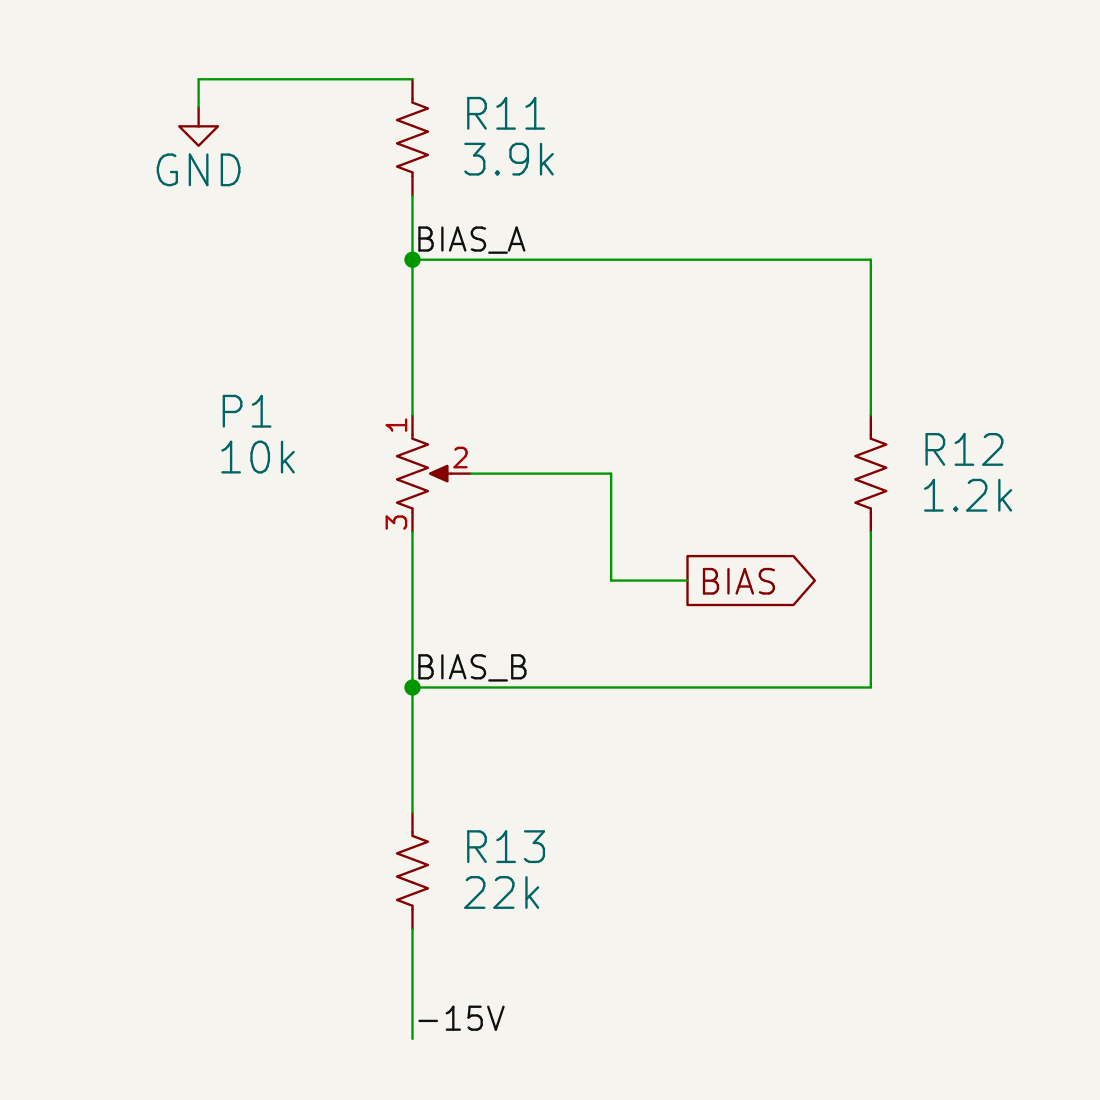
[picture p44: page 1]
