NateDogg247/EEE3094S---Lab-2-PTRJUN003-/report/figures/kicad_controller.pdf

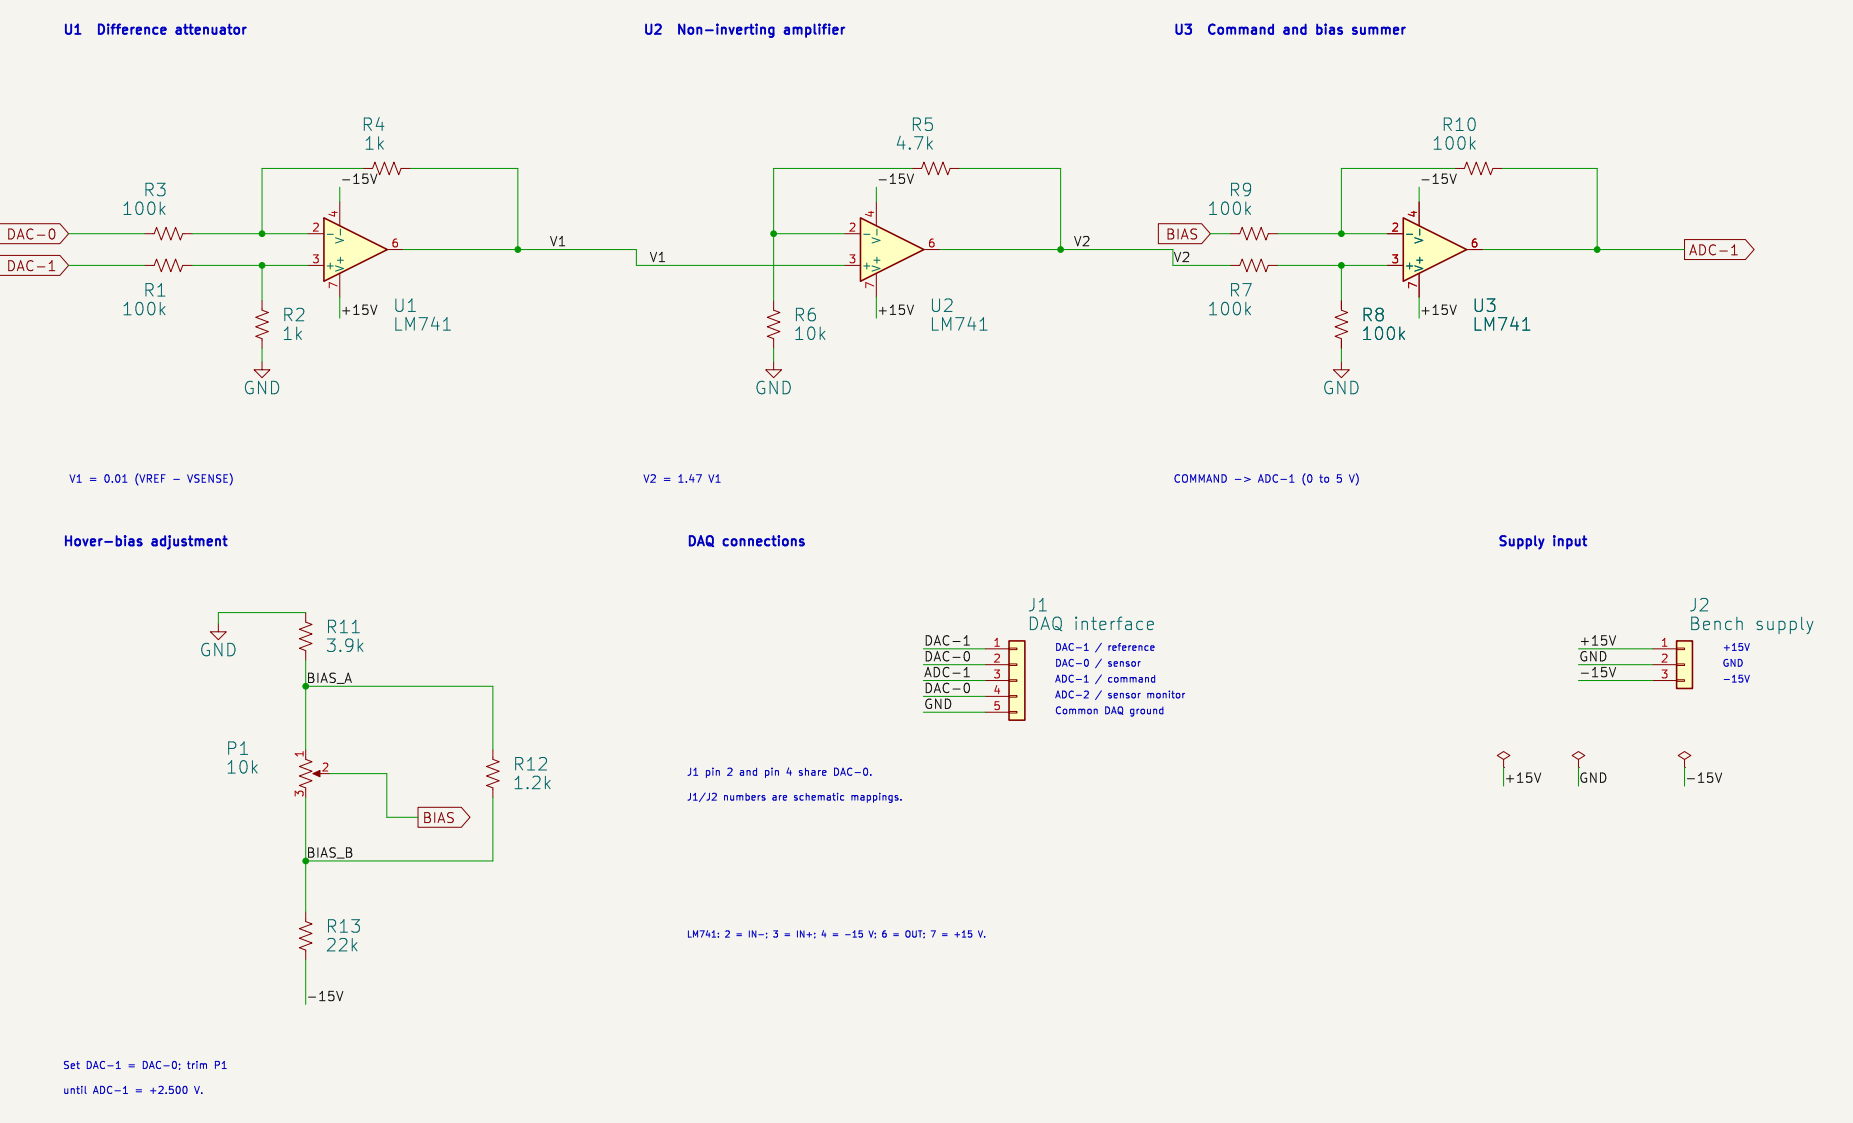
[picture p45: page 1]
