NateDogg247/EEE3094S---Lab-2-PTRJUN003-/report/figures/kicad_signal_stages.pdf

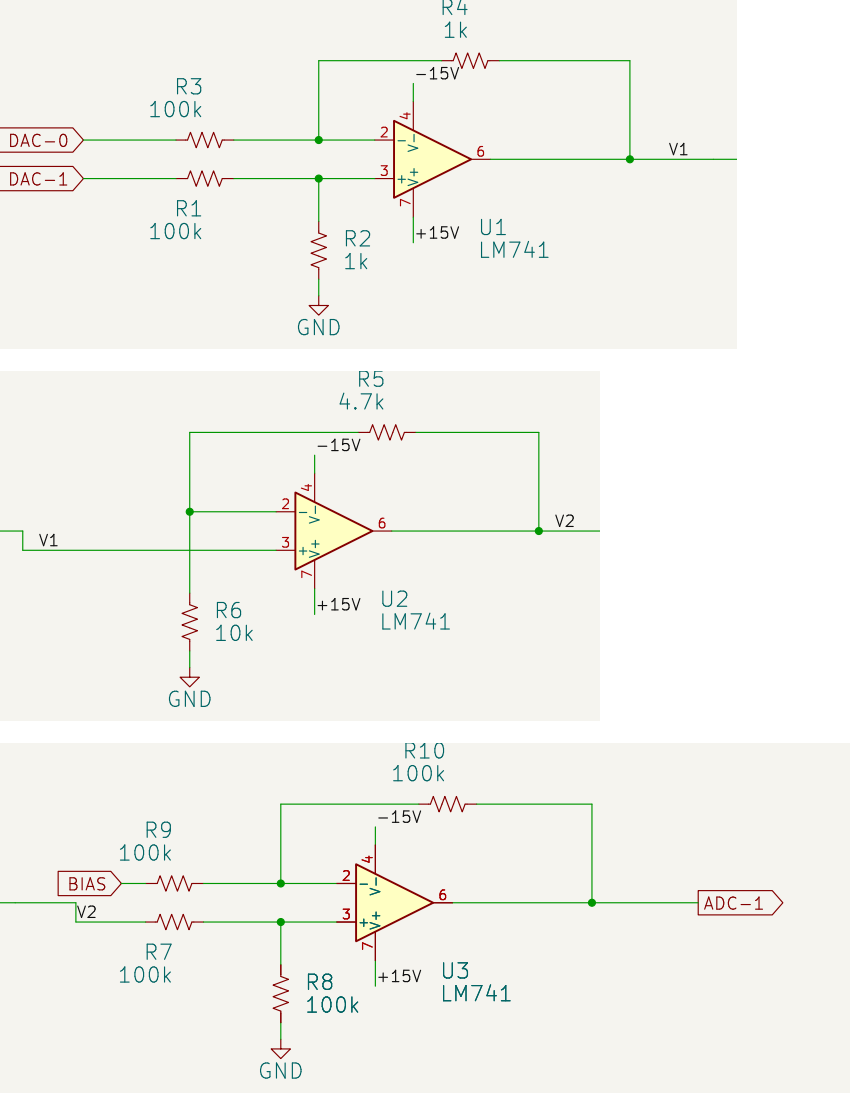
[picture p46: page 1]
