NateDogg247/EEE3094S---Lab-2-PTRJUN003-/report/figures/step_input_transition.pdf

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

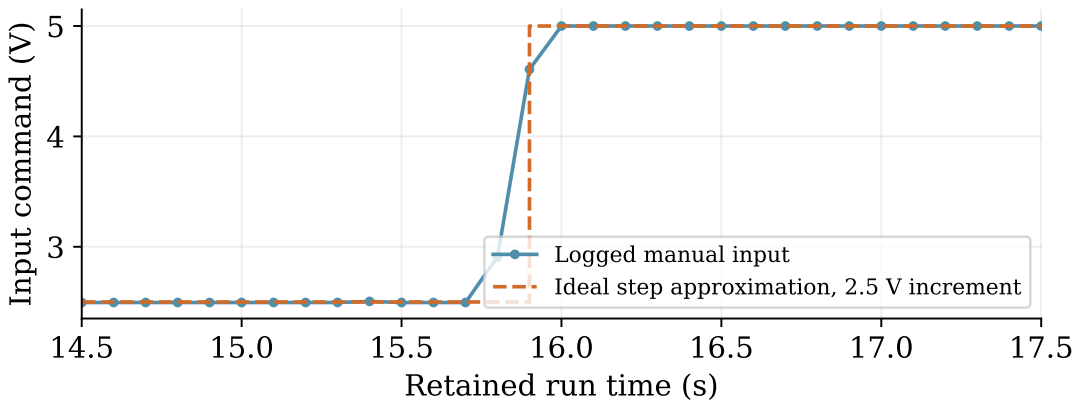
[picture p50: page 1]
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
