NateDogg247/EEE3094S---Lab-2-PTRJUN003-/hardware/Kitticopter_3OpAmp_Controller.asc

C1: cap; 100n
C2: cap; 100n
C3: cap; 100n
C4: cap; 100n
C5: cap; 100n
C6: cap; 100n
P1_BOT: res; {10k*(1-W)}
P1_TOP: res; {10k*W}
R1: res; 100k
R2: res; 1k
R3: res; 100k
R4: res; 1k
R5: res; 4.7k
R6: res; 10k
R7: res; 100k
R8: res; 100k
R9: res; 100k
R10: res; 100k
R11: res; 3.9k
R12: res; 1.2k
R13: res; 22k
U1: UniversalOpamp2; Avol=200k GBW=1Meg Slew=0.5Meg; ilimit=25m rail=2 Vos=0 phimargin=60
U2: UniversalOpamp2; Avol=200k GBW=1Meg Slew=0.5Meg; ilimit=25m rail=2 Vos=0 phimargin=60
U3: UniversalOpamp2; Avol=200k GBW=1Meg Slew=0.5Meg; ilimit=25m rail=2 Vos=0 phimargin=60
VCC_SRC: voltage; 15
VEE_SRC: voltage; -15
VREF_SRC: voltage; 4.65
VSENSE_SRC: voltage; 4.65
Named nets: VREF, VSENSE, 0, WIPER, COMMAND, VCC, VEE
KITTICOPTER THREE-OP-AMP CONTROLLER  |  Kp ~= 0.01432 V/V
Plant: 14.2748/[s(8.1s+1)]    Sensor: 0.93 V/m    Hardware op-amps: 741, +/-15 V
U1: subtract and attenuate x0.01
U2: non-inverting gain x1.47
U3: add calibrated +2.5 V bias
U1_OUT = 0.01*(VREF - VSENSE)
U2_OUT = 1.47*U1_OUT
V(COMMAND) ~= 2.5 + 0.01432*(VREF - VSENSE)
DAQ / bench test sources
DAC-1 setpoint: 4.65 V for 5 m
DAC-0 / ADC-2 sensor feedback: 4.65 V at 5 m
Power rails
100 nF decoupling at EACH op-amp: VCC->GND and VEE->GND
BIAS POTENTIOMETER NETWORK
R11=3.9k to GND, P1=10k, R12=1.2k shunt across P1, R13=22k to -15 V
P1 is represented by P1_TOP + P1_BOT.  W=0 is top end; W=1 is bottom end.
Nominal calibrated setting W=0.7830806 gives WIPER ~= -2.500 V when VREF=VSENSE=4.65 V.
CALIBRATION
1) Set VREF = VSENSE = 4.650 V.
2) Adjust W (hardware: P1) until V(COMMAND) = +2.500 V.
3) Keep P1 fixed during tracking.
The 1.2k shunt narrows the pot range and the finite loading gives Kp ~= 0.0143219 V/V.
741 hardware pin reminder: pin 7=+15 V, pin 4=-15 V; pins 1, 5 and 8 unused.
UniversalOpamp2 is used here with approximate 741 dynamics so the schematic runs without an external model.
.param W=0.7830806
.op
