NateDogg247/EEE3094S---Lab-2-PTRJUN003-/hardware/kicad/Kitticopter_3OpAmp_Controller.kicad_sch

## KiCad design hardware/kicad/Kitticopter_3OpAmp_Controller.kicad_sch (2026-10-11)

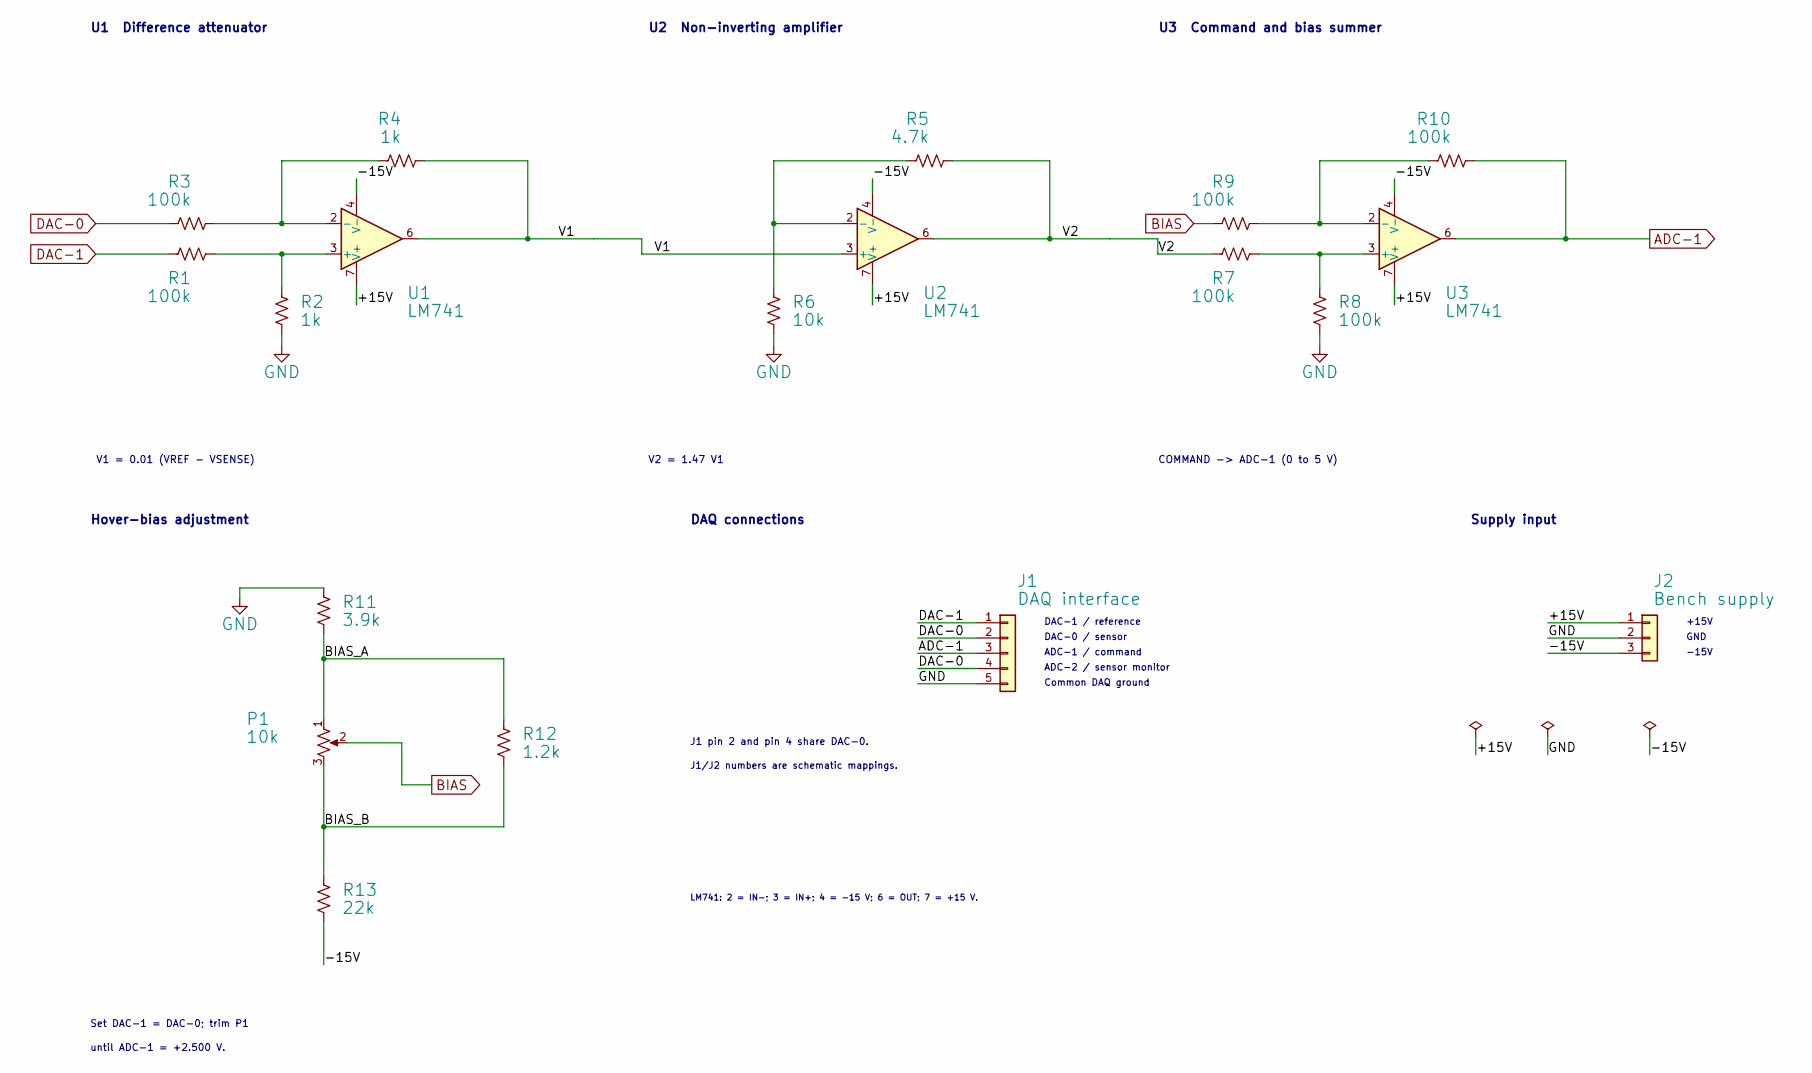
[picture p53: schematic Kitticopter_3OpAmp_Controller.kicad_sch]

Parts:
J1: DAQ interface
J2: Bench supply
P1: 10k
R1, R3, R7, R8, R9, R10: 100k
R2, R4: 1k
R5: 4.7k
R6: 10k
R11: 3.9k
R12: 1.2k
R13: 22k
U1, U2, U3: LM741; DIP-8_W7.62mm

Connections:
+15V: J2.1, U1.7 (V+), U2.7 (V+), U3.7 (V+)
-15V: J2.3, R13.2, U1.4 (V-), U2.4 (V-), U3.4 (V-)
ADC-1: J1.3, R10.2, U3.6
BIAS: P1.2, R9.1
BIAS_A: P1.1, R11.2, R12.1
BIAS_B: P1.3, R12.2, R13.1
DAC-0: J1.2, J1.4, R3.1
DAC-1: J1.1, R1.1
GND: J1.5, J2.2, R2.2, R6.2, R8.2, R11.1
unnamed: R1.2, R2.1, U1.3 (+)
unnamed: R3.2, R4.1, U1.2 (-)
unnamed: R5.1, R6.1, U2.2 (-)
unnamed: R7.2, R8.1, U3.3 (+)
unnamed: R9.2, R10.1, U3.2 (-)
V1: R4.2, U1.6, U2.3 (+)
V2: R5.2, R7.1, U2.6

Notes on the sheet:
U1 Difference attenuator
U2 Non-inverting amplifier
U3 Command and bias summer
V1 = 0.01 (VREF - VSENSE)
V2 = 1.47 V1
COMMAND -> ADC-1 (0 to 5 V)
Hover-bias adjustment
Set DAC-1 = DAC-0; trim P1
until ADC-1 = +2.500 V.
DAQ connections
DAC-1 / reference
DAC-0 / sensor
ADC-1 / command
ADC-2 / sensor monitor
Common DAQ ground
J1 pin 2 and pin 4 share DAC-0.
J1/J2 numbers are schematic mappings.
Supply input
+15V
GND
-15V
LM741: 2 = IN-; 3 = IN+; 4 = -15 V; 6 = OUT; 7 = +15 V.
