NateDogg247/EEE3094S---Lab-2-PTRJUN003-/(commit log)

2026-10-11 Organise Lab 2 code and add 14-page report, worked calculations and GitHub links
    [BOM.csv, Kitticopter_3OpAmp_Controller.sch, PTRJUN003_raw.csv, hardware_screenshot_digitised.csv, independent_resistor_corners.csv, nominal_simulation.csv, session1_processed.csv]
2026-10-11 Preserve exact CSV bytes in supporting evidence
    [BOM.csv, PTRJUN003_raw.csv]
2026-10-11 Add native KiCad controller redraw with diagram exports and connectivity checks
    [BOM.csv, Kitticopter_3OpAmp_Controller.kicad_sch]
2026-10-11 Revise 14-page report with linked Python/MATLAB plots, Simulink comparison and simplified KiCad circuit
    [BOM.csv, Kitticopter_3OpAmp_Controller.kicad_sch, Kitticopter_3OpAmp_Controller.sch, simulink_reference_reconstruction.csv, simulink_scope_digitised.csv]
2026-10-11 Condense report to 15 pages and clarify signal architecture
    Add all original lab images and vector diagrams, enlarge KiCad views, validate clickable report links, and remove redundant navigation pages and launchers.
    [Kitticopter_3OpAmp_Controller.kicad_sch, session1_measured_input_validation.csv]
